antwang0/VGACorne/firmware/README.md

# Firmware

Two firmware families, chosen by the MCU module:

| Module | Firmware | Where |
|---|---|---|
| AT32F405 | [libhmk](https://github.com/peppapighs/libhmk), 8 kHz | `libhmk/keyboards/vgacorne_at32` |
| STM32F446 | libhmk, 1 kHz | `libhmk/keyboards/vgacorne_f446` |
| STM32F446 | QMK, 1 kHz | `qmk/keyboards/vgacorne` |

## libhmk

libhmk (GPL-3.0) runs with one patch; these directories hold the keyboard
definitions, laid out the way libhmk expects, and the patch:

```
libhmk/keyboards/vgacorne_at32/   AT32F405 module: USB high speed, 8 kHz
libhmk/keyboards/vgacorne_f446/   STM32F446 module: USB full speed, 1 kHz
  keyboard.json   generated by hardware/generate.py firmware; don't hand-edit the analog
                  or detachable sections
libhmk/detachable.patch           hot-plugging the VGA cable (below)
libhmk/tests/                     host test of the patched matrix.c (LIBHMK=... ./run.sh)
```

**Hot-plugging (`detachable.patch`).** Stock libhmk learns each key's rest
value only in the first 500 ms after boot, so the cable had to go in before
USB. The patch adds an optional `detachable` block to `keyboard.json`: a detect
pin and the keys behind it. We generate it with `DET` (PC4, low while the cable
is in) and the left half's 23 keys.
- **Cable out:** those keys are released at once and held. Their inputs float,
  so their readings are ignored, and can't press keys or skew the learned
  bottom-out values.
- **Cable in:** their rest values are learned afresh over 500 ms while the
  right half keeps working. Contact bounce while plugging in just restarts the
  500 ms.

The patch touches the schema, `make.py`, both drivers' `analog.c` (the detect
pin) and `matrix.c`. Without it libhmk ignores the block, and
`generate.py check` with `LIBHMK` set reports the missing patch.

Both share the same key map and mux wiring (the two MCUs use the same pin
numbers); they differ in driver, crystal (12 vs 8 MHz), USB port and PID.

## Build

```sh
git clone https://github.com/peppapighs/libhmk && cd libhmk
git apply <this repo>/firmware/libhmk/detachable.patch
cp -r <this repo>/firmware/libhmk/keyboards/vgacorne_* keyboards/
pip install platformio "pydantic~=2.11"
python setup.py -k vgacorne_at32    # or vgacorne_f446
pio run                             # -> .pio/build/<keyboard>/firmware.bin (DFU suffix added)
```

Checked against libhmk `main` (`1d2b2e2`, July 2026) in October 2026, with the
patch: AT32 33.5 KB flash / 13 KB RAM, F446 37.3 KB flash / 13 KB RAM. The left half's two mouse-column keys
are `MS_BTN1`/`MS_BTN2`; libhmk has no encoder support, so its rotary encoder
does nothing there.

## QMK (STM32F446 module)

QMK has no hall-effect support, so the keyboard brings its own analog matrix
(QMK "custom matrix lite"):

```
qmk/keyboards/vgacorne/
  he_matrix.c/.h     scan, calibration, travel curve, fixed actuation + rapid trigger, rotary encoder
  vgacorne.c         HE settings in EEPROM, HE_* keycodes, bring-up console output
  keyboard.json      generated: layout with matrix positions traced from the schematics
  he_wiring.h        generated: pins, ADC channels, remote rows, cable detect, curve table,
                     rotary encoder channel and levels, trackpad settings
  rules.mk           generated: matrix source + the trackpad's QMK driver
  config.h, halconf.h, mcuconf.h, keymaps/default (keymap.c, rules.mk)
qmk/tests/           host test of he_matrix.c against simulated sensors (./run.sh)
```

Matrix row = ADC input, column = mux channel. One scan steps all eight mux
channels and converts the six ADC inputs in a single sequence, taking about
0.23 ms. It uses `DET` (PC4) to hold the satellite half released while the VGA
cable is out and to recalibrate it when the cable comes back, as libhmk does
with `detachable.patch`.

**Trackpad.** The optional trackpad beside Y/H/N is chosen in
`hardware/vgacorne/trackpad.py`. Its QMK driver and settings are generated
into `rules.mk` and `he_wiring.h`, and it runs on I2C1 (PB6/PB7) at 400 kHz.
- **Azoteq TPS65** (default): `azoteq_iqs5xx`. Tap clicks, a two-finger tap
  right-clicks, and two fingers scroll.
- **Cirque TM040040:** `cirque_pinnacle_i2c`, with tap-to-click and circular
  scroll.
- **Buttons:** the left half's mouse column has right click beside T and
  left click beside G, with the rotary encoder below; the lower layer's left
  home row has all three buttons too.
- **Without a pad:** the driver's one failed init costs about 0.1–0.3 s at
  boot.

**Rotary encoder.** Its two contacts are summed into one of four voltages on
the left half's last spare mux channel (see
[architecture](../docs/architecture.md#mouse-column-left-half)). `he_matrix.c`
keeps that reading each scan and answers QMK's quadrature driver through
`encoder_quadrature_read_pin()`, so `ENCODER_ENABLE` and an encoder map are all
the keymap needs. Default map: scroll on base, sideways scroll on lower,
volume on raise. `ENCODER_DIRECTION_FLIP` in `config.h` reverses it.

Build:

```sh
git clone --recurse-submodules https://github.com/qmk/qmk_firmware
ln -s "$PWD/qmk/keyboards/vgacorne" qmk_firmware/keyboards/vgacorne
cd qmk_firmware && make vgacorne:default        # needs arm-none-eabi-gcc >= 10 and dfu-suffix
make vgacorne:default:flash                     # hold BOOT while plugging in first
```

Built against QMK master (September 2026) with GCC 15: 36.8 KB with the
TPS65 driver and the rotary encoder, no warnings.
GCC 7 is too old for current QMK's USB code.

| Keycode | Action |
|---|---|
| `HE_ACTU` / `HE_ACTD` | actuation point 0.1 mm deeper / shallower (default 1.5 mm) |
| `HE_RTTG` | rapid trigger on/off |
| `HE_RTSU` / `HE_RTSD` | rapid trigger less / more sensitive (default 0.3 mm) |
| `HE_CALB` | recalibrate every key (hands off for half a second) |
| `HE_DBG` | print raw/rest/bottom/distance per key (`CONSOLE_ENABLE = yes`, `qmk console`) |

The layout macro is `LAYOUT`: the Corne's 42 keys in `LAYOUT_split_3x6_3`
order, then the two mouse-column keys.

Settings persist in flash sector 1 through QMK's legacy wear-levelling
driver. ChibiOS's embedded-flash driver doesn't support the F446, and the
legacy driver only has presets for the F401/F411, which share its sector
layout; `config.h` supplies the F446 values.

**Not done yet:**
- Trackpad reads in their own thread, so they can't hold up the key scan, and
  the fix for QMK's Azoteq tap bug. Planned in
  [pointing-devices.md](pointing-devices.md), along with rotary-encoder and
  trackpad support for libhmk.
- VIA / Vial configuration. Settings are keycode-driven for now.
- Per-key actuation, DKS and SOCD. Keychron's GPL-2+ `analog_matrix` module
  has these and could be merged in.
- Fitting the travel curve (`travel_curve` in `SENSOR`) to our sensor and
  magnet. The default was fitted for GEON Raw HE switches with OH49E sensors.

## Key indices

```
 0  1  2  3  4  5 43      6  7  8  9 10 11
12 13 14 15 16 17 42     18 19 20 21 22 23
24 25 26 27 28 29 ()     30 31 32 33 34 35
          36 37 38      39 40 41
```

42 is left click, 43 right click, `()` the rotary encoder.

The default keymap is base / lower (`MO(1)`) / raise (`MO(2)`) / adjust (hold
both). Adjust has `SP_BOOT` on key 0 and profile switching `PF(0..3)`. Change
everything else in [hmkconf](https://hmkconf.com): keymaps, actuation points,
rapid trigger, tap-hold.
