antwang0/VGACorne/docs/img/module_f446-bottom.png

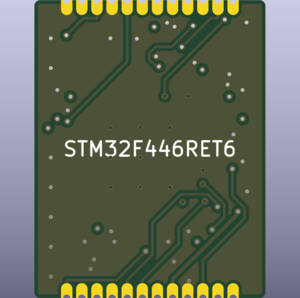
docs/img/module_f446-bottom.png
