antwang0/VGACorne/docs/img/module_f446-top.png

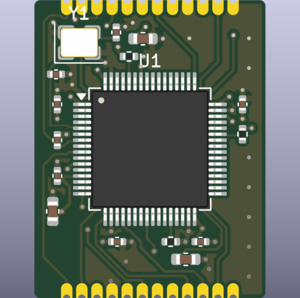
docs/img/module_f446-top.png
