antwang0/VGACorne/docs/img/satellite-bottom.png

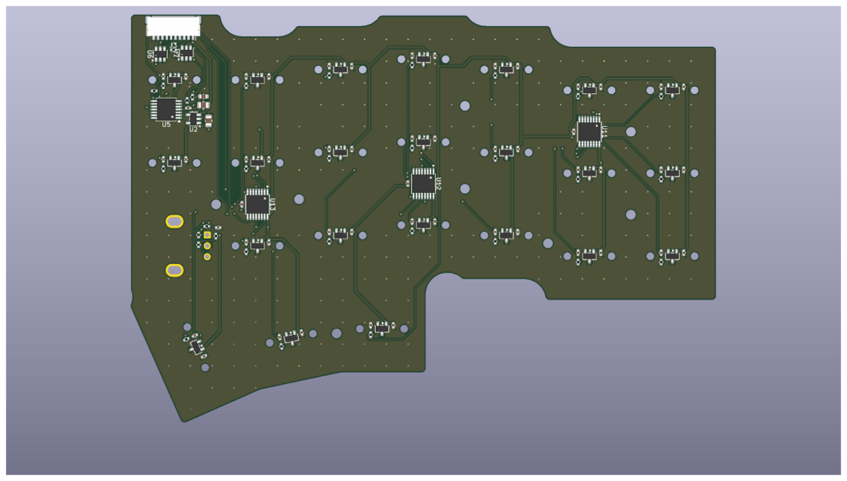
docs/img/satellite-bottom.png
