antwang0/VGACorne/hardware/bom/vgacorne-module-at32.csv

Refs | Value | Tolerance | Footprint | MPN | Qty | DNP
C1-C3,C5,C9 | 100n |  | Capacitor_SMD:C_0402_1005Metric |  | 5
C4 | 4.7u |  | Capacitor_SMD:C_0603_1608Metric |  | 1
C6 | 1u |  | Capacitor_SMD:C_0603_1608Metric |  | 1
C7,C8 | 15p |  | Capacitor_SMD:C_0402_1005Metric |  | 2
R1 | 12k | 1% | Resistor_SMD:R_0402_1005Metric |  | 1
R2 | 10k |  | Resistor_SMD:R_0402_1005Metric |  | 1
U1 | AT32F405RCT7 |  | Package_QFP:LQFP-64_10x10mm_P0.5mm | AT32F405RCT7 | 1
Y1 | 12MHz |  | Crystal:Crystal_SMD_3225-4Pin_3.2x2.5mm | X322512MOB4SI | 1
