antwang0/VGACorne/hardware/bom/vgacorne-link.csv

Refs | Value | Tolerance | Footprint | MPN | Qty | DNP
C1 | 100n |  | Capacitor_SMD:C_0402_1005Metric |  | 1
J1 | 10090929-S154XLF |  | vgacorne:DSUB-15-HD_Socket_Vertical_P2.29x1.98mm_Amphenol_10090929 | Amphenol FCI 10090929-S154XLF | 1
J2 | JST-SH pigtail |  | vgacorne:WirePads_1x10_P1.6mm |  | 1
