antwang0/VGACorne/hardware/mechanical/case-machined/case-left-tray.step

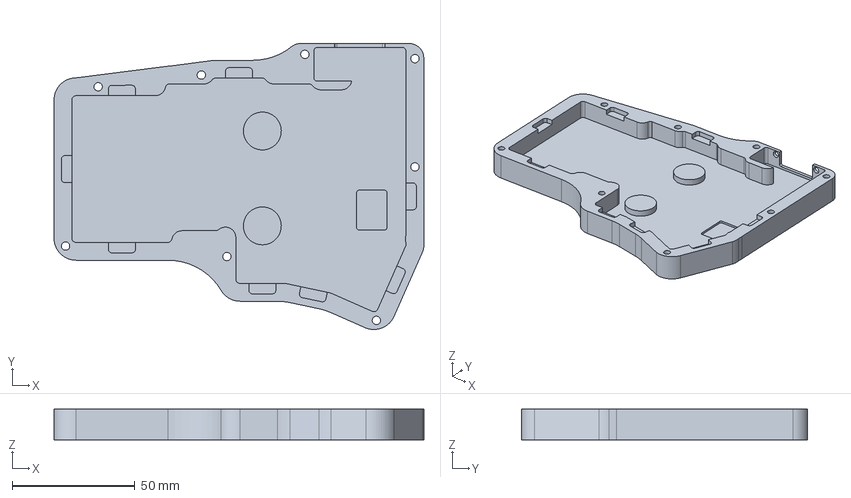
[picture p13: CAD file, 2026-11-03]
hardware/mechanical/case-machined/case-left-tray.step
150.4 x 116.3 x 12.6 mm
