antwang0/VGACorne/hardware/mechanical/case-plan-left.dxf

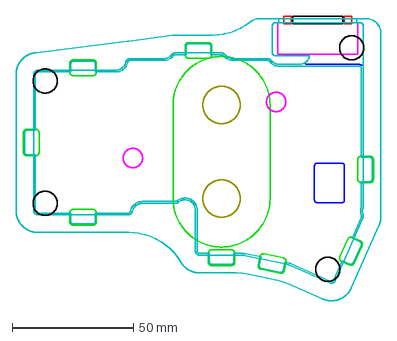
[picture p14: CAD file, 2026-11-02]
hardware/mechanical/case-plan-left.dxf
150.4 x 117.3 mm
