antwang0/VGACorne/hardware/mechanical/case-printed/case-right-frame.step

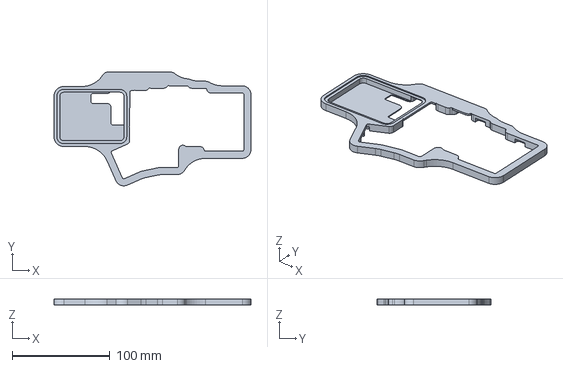
[picture p15: CAD file, 2026-11-03]
hardware/mechanical/case-printed/case-right-frame.step
201.4 x 116.3 x 6.50 mm
