antwang0/VGACorne/hardware/mechanical/case-machined/case-left-frame.step

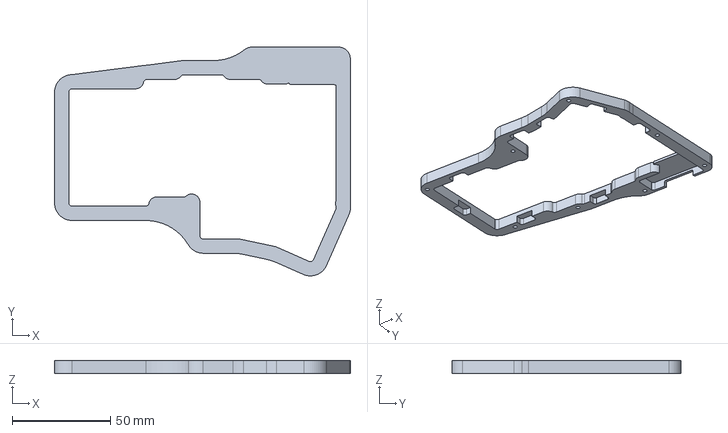
[picture p16: CAD file, 2026-11-03]
hardware/mechanical/case-machined/case-left-frame.step
150.4 x 116.3 x 6.50 mm
