antwang0/VGACorne/hardware/mechanical/case-plan-right.dxf

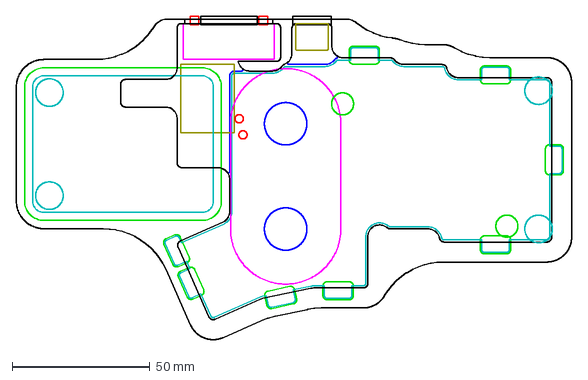
[picture p17: CAD file, 2026-11-02]
hardware/mechanical/case-plan-right.dxf
201.5 x 117.3 mm
