antwang0/VGACorne/hardware/mechanical/case-printed/case-right-tray.step

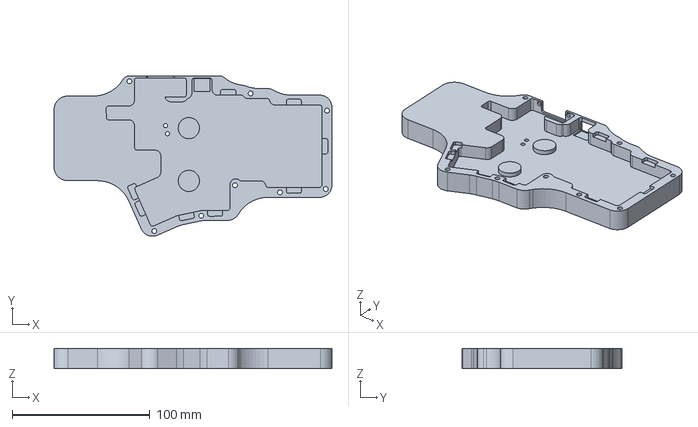
[picture p18: CAD file, 2026-11-03]
hardware/mechanical/case-printed/case-right-tray.step
201.4 x 116.3 x 14.6 mm
