antwang0/VGACorne/hardware/mechanical/case-machined/case-right-tray.step

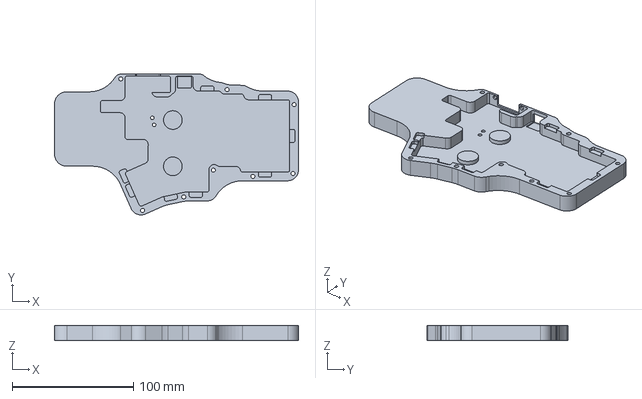
[picture p19: CAD file, 2026-11-03]
hardware/mechanical/case-machined/case-right-tray.step
201.4 x 116.3 x 12.6 mm
