antwang0/VGACorne/hardware/mechanical/case-printed/case-left-tray.step

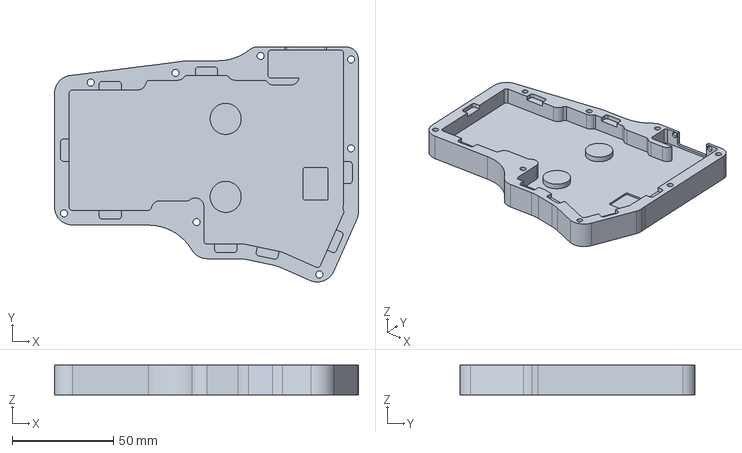
[picture p20: CAD file, 2026-11-03]
hardware/mechanical/case-printed/case-left-tray.step
150.4 x 116.3 x 14.6 mm
