antwang0/VGACorne/hardware/mechanical/foam-case-left.dxf

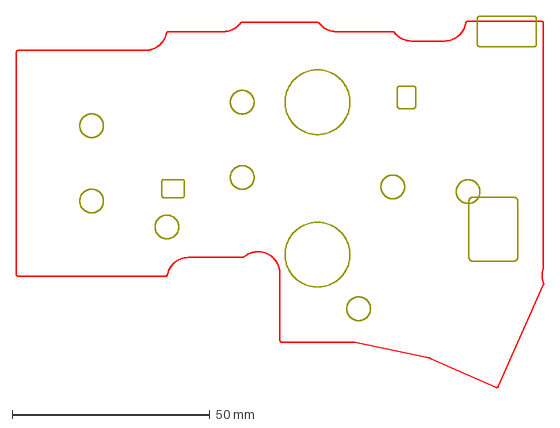
[picture p21: CAD file, 2026-11-02]
hardware/mechanical/foam-case-left.dxf
133.4 x 93.9 mm
