antwang0/VGACorne/hardware/mechanical/case-machined/case-right-frame.step

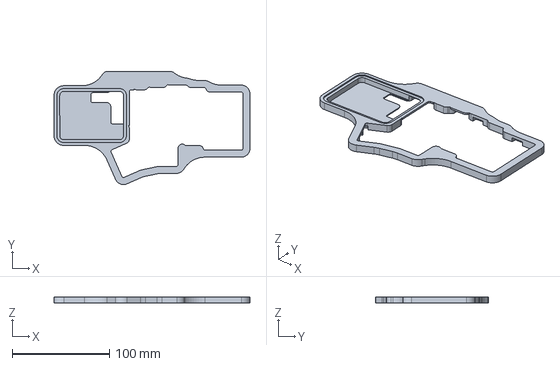
[picture p22: CAD file, 2026-11-03]
hardware/mechanical/case-machined/case-right-frame.step
201.4 x 116.3 x 6.50 mm
