antwang0/VGACorne/hardware/mechanical/foam-case-right.dxf

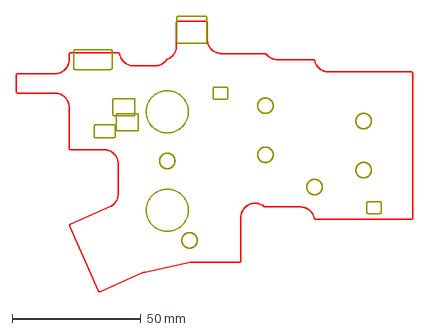
[picture p23: CAD file, 2026-11-02]
hardware/mechanical/foam-case-right.dxf
153.9 x 106.9 mm
