antwang0/VGACorne/hardware/mechanical/plate-left.dxf

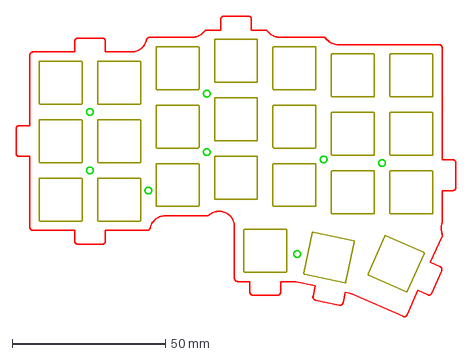
[picture p24: CAD file, 2026-09-29]
hardware/mechanical/plate-left.dxf
143.4 x 98.0 mm
