antwang0/VGACorne/hardware/mechanical/foam-plate-left.dxf

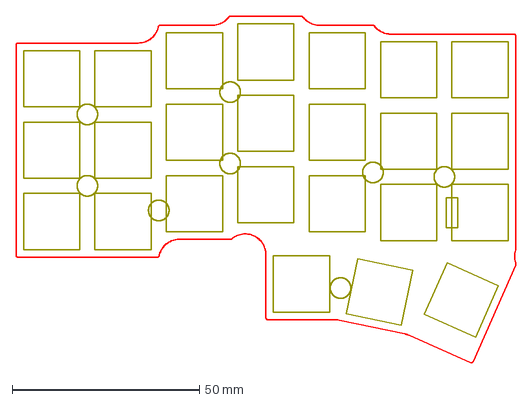
[picture p25: CAD file, 2026-09-29]
hardware/mechanical/foam-plate-left.dxf
133.4 x 92.5 mm
