antwang0/VGACorne/hardware/mechanical/foam-plate-right.dxf

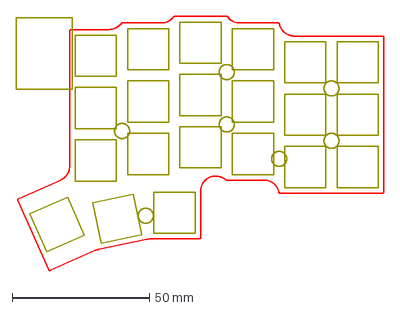
[picture p26: CAD file, 2026-09-29]
hardware/mechanical/foam-plate-right.dxf
133.8 x 92.5 mm
