antwang0/VGACorne/hardware/mechanical/pcb-outline-left.dxf

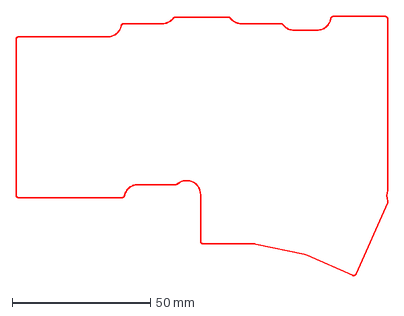
[picture p27: CAD file, 2026-09-29]
hardware/mechanical/pcb-outline-left.dxf
134.4 x 93.7 mm
