antwang0/VGACorne/hardware/mechanical/plate-right.dxf

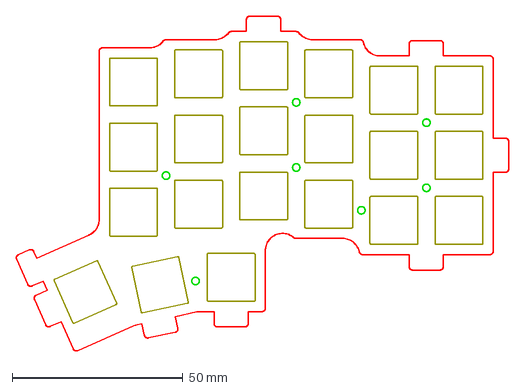
[picture p28: CAD file, 2026-09-29]
hardware/mechanical/plate-right.dxf
144.0 x 98.0 mm
