antwang0/VGACorne/hardware/mechanical/pcb-outline-right.dxf

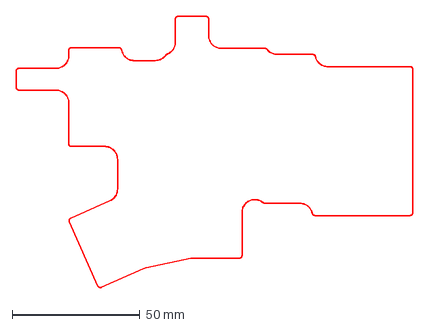
[picture p29: CAD file, 2026-09-29]
hardware/mechanical/pcb-outline-right.dxf
154.9 x 105.9 mm
