antwang0/VGACorne/(list of files, cad)

Other CAD files:
hardware/mechanical/case-printed/case-left-frame.step
hardware/mechanical/case-right-frame-inserts.step
hardware/mechanical/case-right-frame-tapped.step
hardware/mechanical/case-left-tray-tapped.step
hardware/mechanical/case-left-frame-tapped.step
hardware/mechanical/case-right-tray-tapped.step
hardware/mechanical/case-left-frame-inserts.step
hardware/mechanical/case-right-tray-inserts.step
hardware/mechanical/case-left-tray-inserts.step
hardware/mechanical/case-right-frame.step
hardware/mechanical/case-left-frame.step
hardware/mechanical/case-left-frame-tapped.dxf
hardware/mechanical/case-left-tray-tapped.dxf
hardware/mechanical/case-machined/case-left-frame.dxf
hardware/mechanical/case-machined/case-left-tray.dxf
hardware/mechanical/case-machined/case-right-frame.dxf
hardware/mechanical/case-machined/case-right-tray.dxf
hardware/mechanical/case-printed/case-left-frame.stl
hardware/mechanical/case-printed/case-left-tray.stl
hardware/mechanical/case-printed/case-right-frame.stl
hardware/mechanical/case-printed/case-right-tray.stl
hardware/mechanical/case-right-frame-tapped.dxf
hardware/mechanical/case-right-tray-tapped.dxf
