antwang0/VGACorne/docs/bring-up.md

# Ordering, assembly and bring-up

## Before ordering

- [ ] Run `hardware/generate.py check`: it must show 0 DRC errors, and
      `unconnected_items` must reach 0 on every board.
- [ ] If you swapped mux channels while routing, run `generate.py firmware`.
- [ ] Run `hardware/generate.py fab` and upload `hardware/fab/<board>/` to
      JLC: the Gerber zip, then the BOM and CPL for assembly. Check the parts'
      rotations in JLC's placement preview (hardware/README.md, *Ordering from
      JLC*).
- [ ] The VGA socket is the Amphenol FCI 10090929-S154XLF (the daughterboard
      footprint has its 1.2 mm pin holes), with Keystone 7229 jackscrews.
      Only 10 at LCSC; Digi-Key has thousands.
- [ ] Check stock for the DRV5055A3QDBZR. The second source is the
      MT9102ET; it reads the other way round, so flip `invert_adc`. See
      [sensors.md](sensors.md) and *Sensor polarity* below.
- [ ] Prefer DRV5055s on TI's newer LBC9 process: 2 mA typical instead of
      6 mA, see the [power budget](architecture.md#power-budget-usb-500-ma).
      - From ti.com, their packaging label says "Rev: C" and "CSO: RFAB".
      - Elsewhere, ask the distributor, or measure a few before buying all 44.
      - Assembly houses like JLC use whatever lot they stock; bring-up step 1
        tells you which you got. Either kind works.

## What to order

What it comes to: [cost.md](cost.md).

| Item | Qty | Notes |
|---|---|---|
| Main PCB (right half), 2-layer 1.6 mm | 1 | two-sided assembly (the trackpad FFC connector J5 is on top); J4 is bare landing pads for the module, soldered on by hand |
| MCU module, **4-layer 1.0 mm**, castellated holes | 1 | AT32F405 (libhmk, 8 kHz) or STM32F446 (QMK / libhmk); everything on top. JLC's standard 1.0 mm 4-layer stack-up (the USB pair assumes ~0.1 mm to the In1 ground plane), with the castellated-hole option |
| Satellite PCB (left half), 2-layer 1.6 mm | 1 | two-sided assembly; the rotary encoder ENC1 on top is THT (LCSC C143785, check stock: JLC may have to pre-order it, or hand-solder it) |
| VGA daughterboard | 2 | hand-solder: DE-15 (Amphenol FCI 10090929-S154XLF), 10-wire pigtail, 0402 cap |
| 4-40 female jackscrews, 0.187" hex, 0.25" stud (Keystone 7229) | 4 | two per DE-15, through the case wall into its clinch nuts |
| Plate (aluminium DXF or FR4 KiCad board) | 1 + 1 mirrored | aluminium: leave it bare or bead-blasted; the grounded standoffs tie it to GND ([grounding.md](grounding.md)) |
| Würth WE-SECF 331236362553 spring fingers (G1, G2) | 4 | aluminium case only; Farnell/RS/Mouser, no LCSC number, hand-soldered on the PCB underside |
| Case: tray + frame per half | 1 + 1 | print `mechanical/case-printed/`, or order `mechanical/case-machined/` in aluminium with its `.dxf` drawings ([mechanical.md](mechanical.md#3d-case)) |
| M3 × 12 button-head screws (ISO 7380) | 16 | tray to frame, eight per half |
| M3 × 4.0 heat-set inserts (ruthex RX-M3Sx4.0, or CNC Kitchen M3 × 3) | 16 | printed case only |
| 1/4"-20 × 6.4 heat-set inserts (CNC Kitchen or ruthex "short") | 4 | printed case only: the tripod/Arca mounts |
| Stick-on rubber feet, ~10 mm across | 8 | at the `FEET` marks in the case plan |
| Tenting or desk mount (optional) | | a mini tripod with a ball head, or an arm with an Arca clamp ([mounting.md](mounting.md)) |
| HE switches (Gateron KS-20 magnetic, GEON Raw HE, ...) | 44 | 42 + the two mouse-button keys |
| Bourns PEC12R-4220F-N0024 encoder | 1 | knob beside B (left half) |
| Knob, ~16 mm across, ~11.5 mm tall, 6 mm D-shaft bore ≥ 9.5 mm deep | 1 | up to 17 mm across; a taller knob needs a ≥ 7.5 mm recess underneath for the encoder's collar ([mechanical.md](mechanical.md#mouse-column-and-rotary-encoder-left-half)) |
| M2 hex standoffs 3.5 mm, brass | 15 | plus 30 × M2 × 3 mm screws |
| 10-pin JST-SH pigtail, ~5 cm, single-ended | 2 | plugs into J3, right in front of the daughterboard |
| VGA cable, male–male | 1 | the classic blue monitor cable is fine. It needs pins 1–3, 5–10 and 12–15 (check pin 9, see JP1/JP2 below). Both ends plug into the back of the case, so ~30 cm reaches round behind the gap |
| Azoteq TPS65-201A-S trackpad (optional) | 1 | end-of-life at Azoteq and out of stock at LCSC; Keycapsss still sells it. GR-Trackpad65 is an open clone |
| Trackpad overlay, 1 mm glass or acrylic, 71 × 55 mm, ~7 mm corners | 1 | non-metal, matte/etched top; laser-cut black acrylic works |
| 6-pin 0.5 mm FFC, ~30 mm | 1 | trackpad to J5 (Jushuo AFC07-S06FCA-00, LCSC C262553, bottom contact). Same-side or opposite-side contacts: decide with the paper mock-up (*Trackpad*, step 2) |
| PORON: 3.18 mm 4701-30 (or 3 mm LE-20) for gaskets, 1.5 mm for case foam, 3.5 mm LE-20 for plate foam | | 32 gasket strips 10 × 4.5 mm; foams cut from the DXFs ([mechanical.md](mechanical.md#foam-and-gaskets)) |

BOMs: `hardware/bom/*.csv`. Choose R11–R13 or R14–R16 to match `invert_adc`
(the DNP flags are already set from `SENSOR`).

## Daughterboards

1. Solder the DE-15 on the front, board locks included: they ground the
   shell. Clip its pin tails on the back to about 1.5 mm.
2. Try it in the case with the jackscrews before wiring. The flange should
   pull flat against the wall. Measure the board-to-flange distance: the
   design assumes about 6.1 mm.
3. On the back, solder the pigtail wires to pads 1–10. Pad 1 is marked by
   the silk bar and carries +5 V. Wire *n* must end up on pin *n* of the J3
   plug, so check the pigtail's colour order with a meter.
4. Leave JP1/JP2 bridged 1–2 (the default) unless your VGA cable lacks pin 9.
   In that case, cut both and bridge 2–3 on **both** boards.

## First power-up (main half alone)

1. **Before soldering the module:** plug in USB through a USB meter and
   measure +5V, +3V3 (U3) and +3.3VA (U2). Both 3.3 V rails are also on J4
   pads 11 and 10.
   - The current now is almost all the 21 sensors. Divide it by 21: about
     2 mA each means LBC9 parts, about 6 mA the older LBC8 ones.
   - Much more than 6 mA each means the [power budget](architecture.md#power-budget-usb-500-ma)
     needs another look.
2. Solder the module on: tack two opposite corner pads, check it sits flat and
   square on J4, then solder the rest along both edges. Plug in again: expect
   the step 1 current plus 50–90 mA for the MCU.
3. Hold **BOOT** while plugging in. The factory DFU bootloader (AT32 or STM32)
   should enumerate. SWD (Tag-Connect J2) is the fallback; it needs the bottom
   tray off.

## Flashing

```sh
git clone https://github.com/peppapighs/libhmk && cd libhmk
git apply ../VGACorne/firmware/libhmk/detachable.patch
cp -r ../VGACorne/firmware/libhmk/keyboards/vgacorne_* keyboards/
python setup.py -k vgacorne_at32 && pio run       # or -k vgacorne_f446 for the STM32 module
```

Build the keyboard that matches the fitted module: the two differ in driver,
crystal and USB speed.

**QMK (STM32F446 module):** `make vgacorne:default:flash` from a QMK checkout
with `firmware/qmk/keyboards/vgacorne` linked in (see
[firmware/README.md](../firmware/README.md#qmk-stm32f446-module)). For bring-up,
build with `CONSOLE_ENABLE = yes`, run `qmk console`, press `HE_DBG`, and watch
each key's value, rest, bottom-out and distance as you press it.

Flash over DFU (`pio run -t upload`, or WebUSB DFU as the libhmk README
suggests). After that, the `SP_BOOT` key (adjust layer: hold both
thumb-layer keys, then the top-left key) or hmkconf can re-enter the
bootloader.

## Sensor polarity and calibration

1. Connect the satellite. Each key's rest value is learned in the first 500 ms
   after USB power-up, and the left half's again for 500 ms whenever the cable
   goes in: keep your hands off the keys meanwhile.
2. Open [hmkconf](https://hmkconf.com) and watch the raw/distance view while
   pressing a key on each half.
   - If distance falls as you press, flip `invert_adc` in
     `hardware/vgacorne/circuits.py` (`SENSOR`), then regenerate: this also
     swaps which cable-unplugged pull resistors are fitted.
   - Set `initial_rest_value` / `initial_bottom_out_threshold` from what you
     observe. The rest value is HE60's; the bottom-out threshold starts at 400
     counts and grows as keys are pressed further.
   - Note the raw value at bottom-out. With the DRV5055A3, if it stays within
     about 740 counts of mid-scale (2048), the field stays under ~40 mT and a
     DRV5055A2 would double the resolution ([sensors.md](sensors.md#notes)).
3. Check every key on both halves reaches full travel. A dead column on one
   half usually means a select or analog line isn't making it through the
   cable. Beep out the VGA cable against the pinout table in
   [architecture.md](architecture.md#vga-link-pinout).
4. Hot-plug, with hmkconf (or `qmk console` and `HE_DBG`) open:
   - Unplug the cable while holding a left-half key. The key should release at
     once, and nothing on the left half should register while it's out.
   - Plug it back in. Within about half a second every left-half key should
     work again, with rest values like before.
   - If not, check that PC4 (`DET`) reads low with the cable in and high with
     it out: JP2 and cable pin 15.

## Rotary encoder (left half, QMK)

1. After soldering ENC1, trim its pins and mounting legs to about 2 mm below
   the PCB. They come through about 3 mm, close to the floor.
2. With the satellite powered, measure the `ENC` node (C5) while turning the
   shaft slowly: it should step between about 0, 1.0, 2.1 and 3.3 V. A level
   that never appears means a contact or one of R21-R24 is off.
3. In QMK the knob scrolls on the base layer, scrolls sideways on lower and
   changes the volume on raise. If it turns the wrong way, add
   `#define ENCODER_DIRECTION_FLIP` to `config.h`. One step per detent is the
   default (`ENCODER_RESOLUTION 4`); set it to 2 if an encoder gives two steps
   per detent.
4. libhmk has no encoder support: the two mouse keys work there, the knob
   doesn't.

## Trackpad (optional, QMK)

For the default Azoteq TPS65:

1. Bond the module, centred, under the overlay using its own adhesive, with a
   3 mm margin all round. Turn it so its connector is near the back edge, on
   the half nearer the keys: it then sits right over J5.
2. Mock up the FFC with a paper strip first: it drops from the module's
   connector straight into J5. Check that module pin 4 (VDDHI) lands on J5's
   +3V3 pin. The fold decides the order.
3. With USB plugged in, measure 3.3 V between the module's VDDHI and GND pads.
4. QMK looks for the pad once, at boot, about 100 ms in. If both axes come out
   reversed, add `AZOTEQ_IQS5XX_ROTATION_180` to the TPS65's `qmk_defines` in
   `trackpad.py` and regenerate (`_90`/`_270` if they come out swapped). Build
   with `CONSOLE_ENABLE = yes` and QMK's `POINTING_DEVICE_DEBUG` to see what the
   driver reads.
5. Check two known issues, see
   [firmware/pointing-devices.md](../firmware/pointing-devices.md): whether a tap
   leaves the left button held, and whether key presses lag while the pad is
   being read.

A Cirque pad (the `cirque40` entry) needs its R1 removed if it is the SPI
version (`-2024-`). Check 3.3 V on its FFC pin 12.

## Troubleshooting

| Symptom | Likely cause |
|---|---|
| Left half dead, right fine | no +5 V on VGA pin 9 (cable variant → JP1/JP2), pigtail miswired, or U8 in current limit (a short on `+5V_LINK`) |
| Left half keys stuck pressed after plugging the cable in late | libhmk built without `detachable.patch`, or `DET` not reaching PC4 (JP2, cable pin 15). Recalibrate in hmkconf or re-plug USB meanwhile |
| One column on the left dead | a `LINK_A/B/C` coax line: cable or daughterboard solder joint |
| Keys fine, trackpad dead | FFC reversed or folded the wrong way, the FFC seated after power-up (QMK only looks at boot), or, for a Cirque, an SPI pad with R1 still fitted |
| Knob scrolls in bursts or backwards on some detents | a missing level on `ENC` (see *Rotary encoder*) |
| Keys trigger randomly with the cable unplugged | `DET` not going high (PC4 shorted, or libhmk without `detachable.patch`), and the pull resistor set doesn't match `invert_adc` |
| Rest value drifts when pressing on the plate | a standoff screw is loose, so the plate flexes against the PCB |
