antwang0/VGACorne/hardware/kicad/main/vgacorne-main.kicad_pcb

## KiCad design hardware/kicad/main/vgacorne-main.kicad_pcb (2026-11-02)

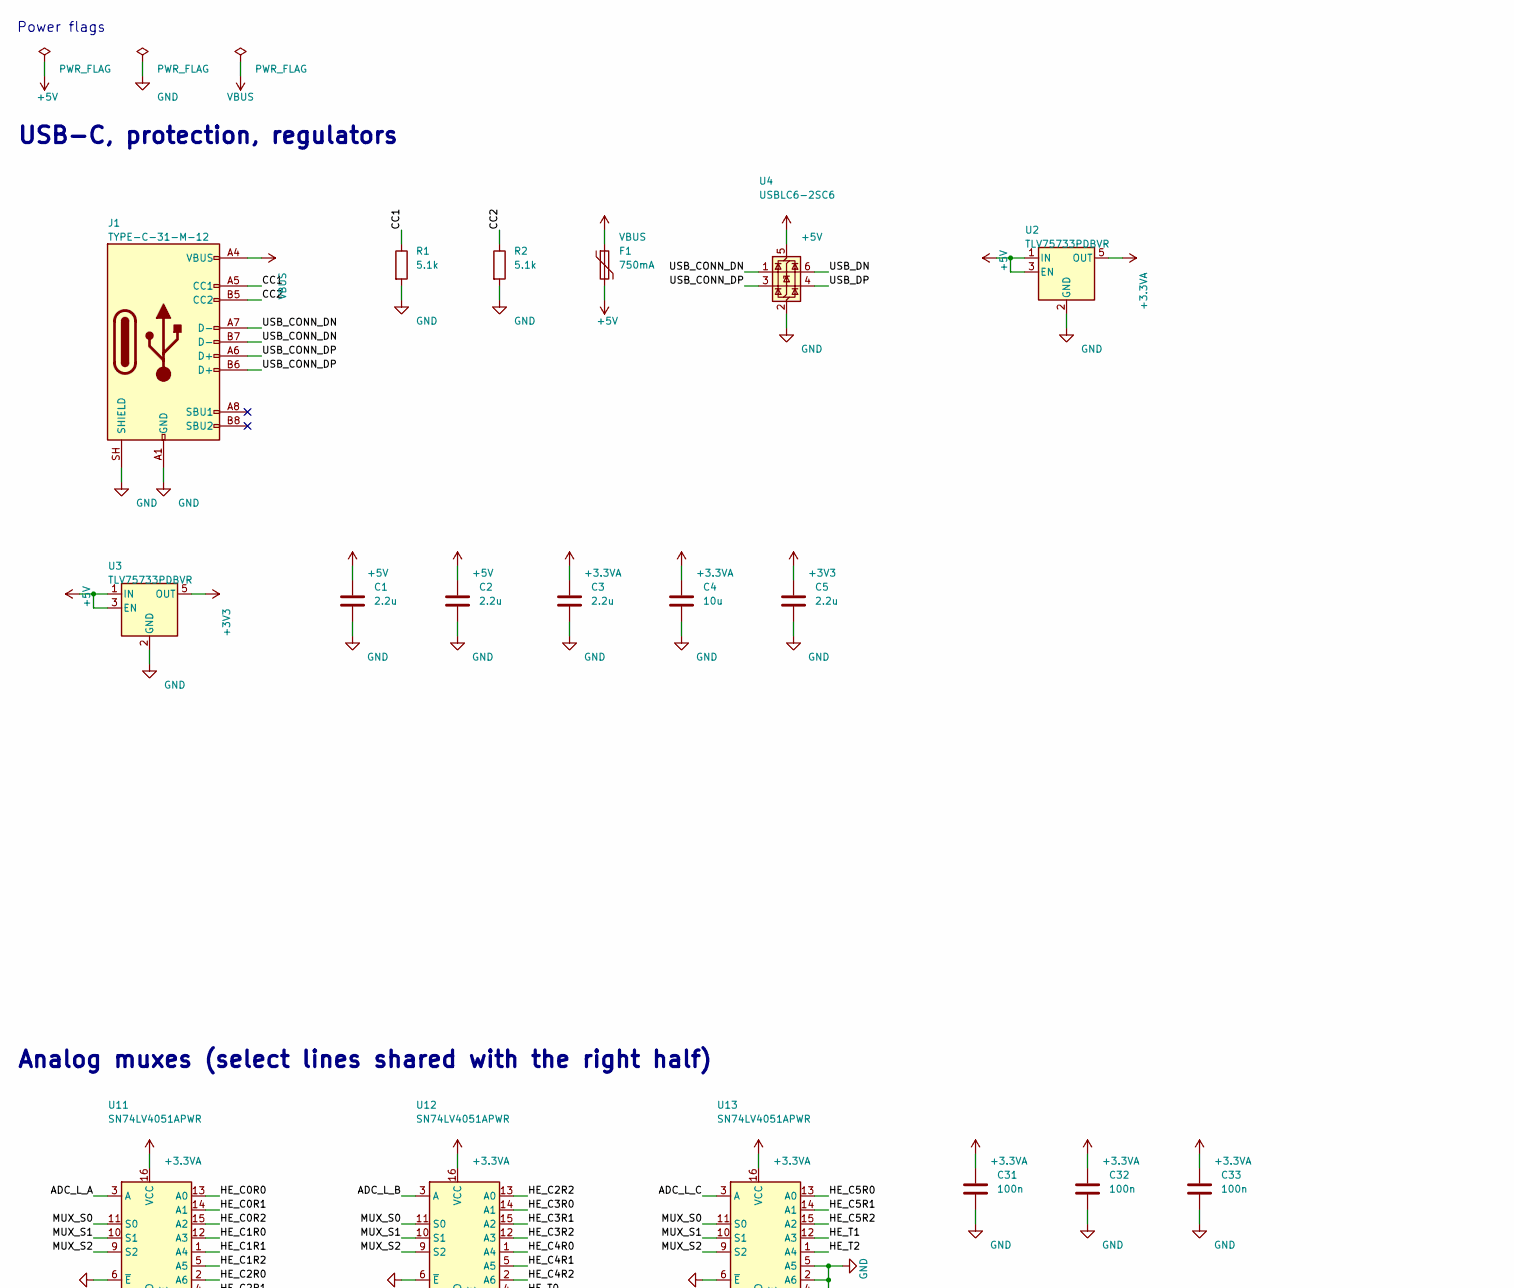
[picture p30: schematic vgacorne-main.kicad_sch, VGACorne - main (right) half, part in row 1, column 1]

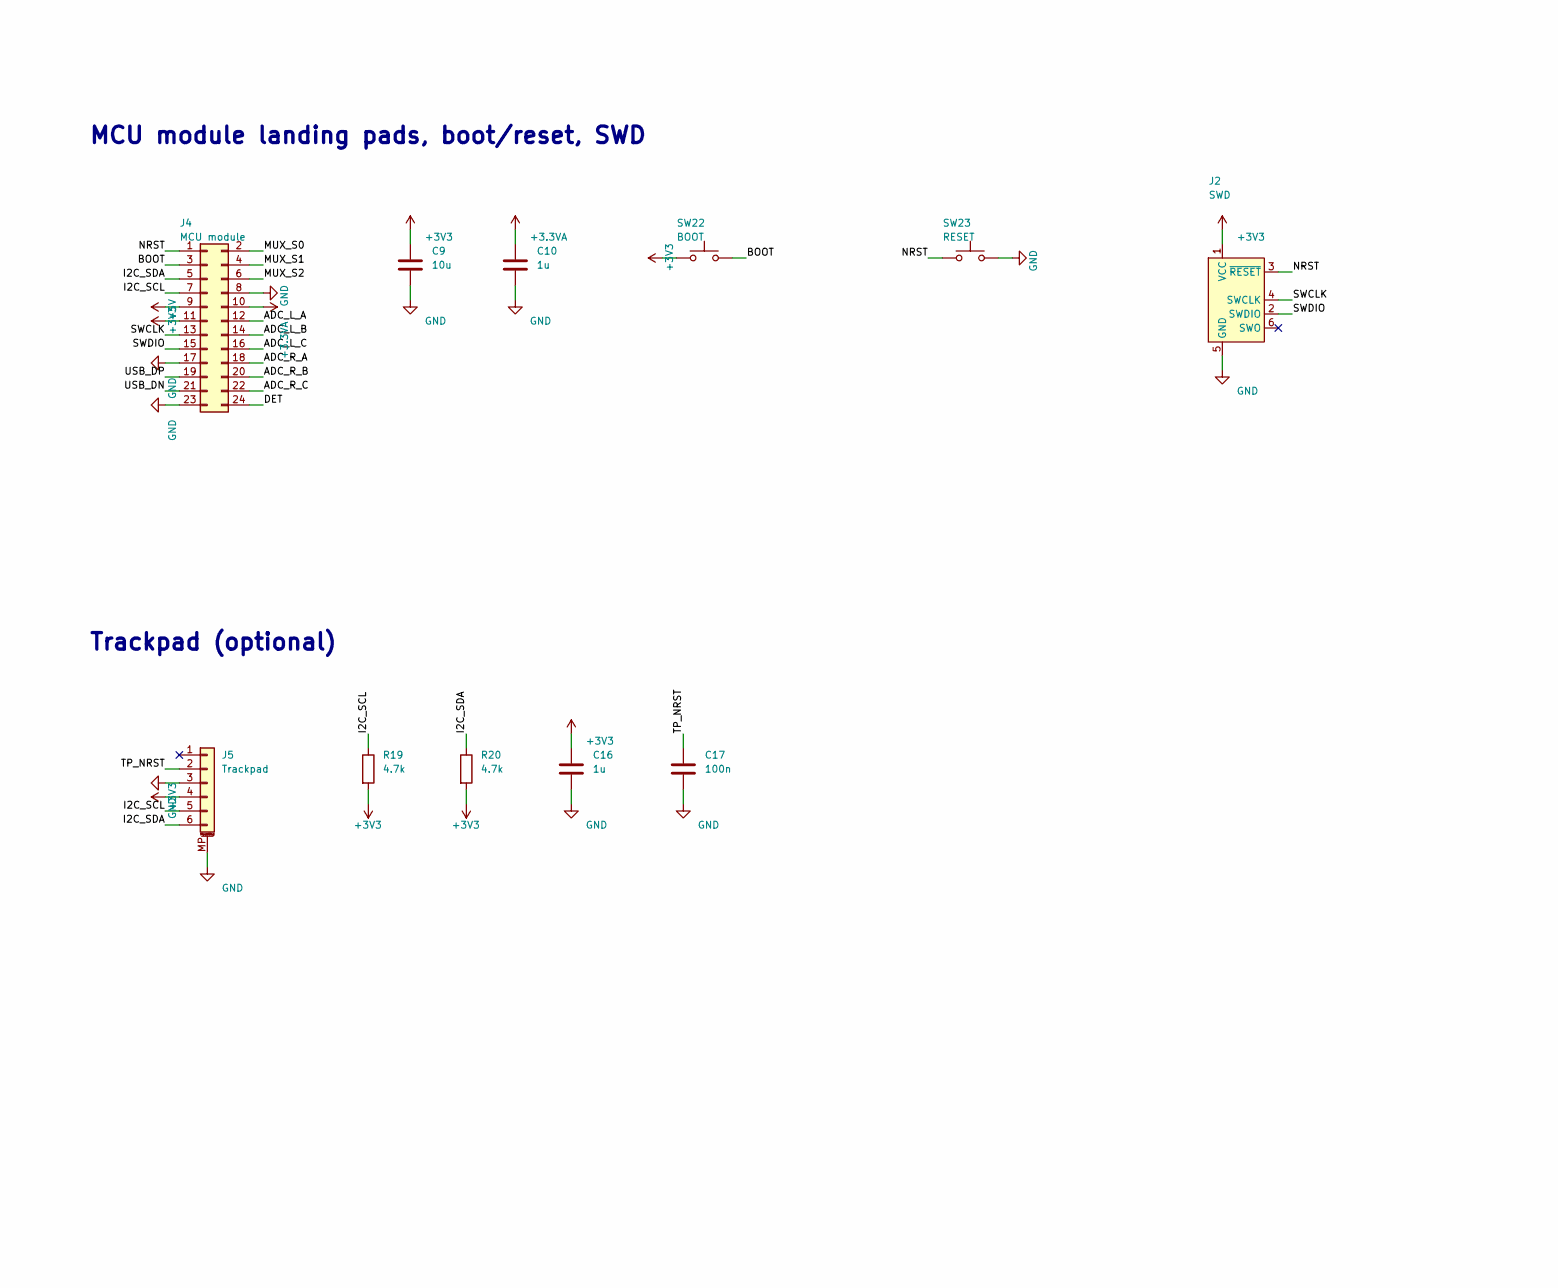
[picture p31: schematic vgacorne-main.kicad_sch, VGACorne - main (right) half, part in row 1, column 2]

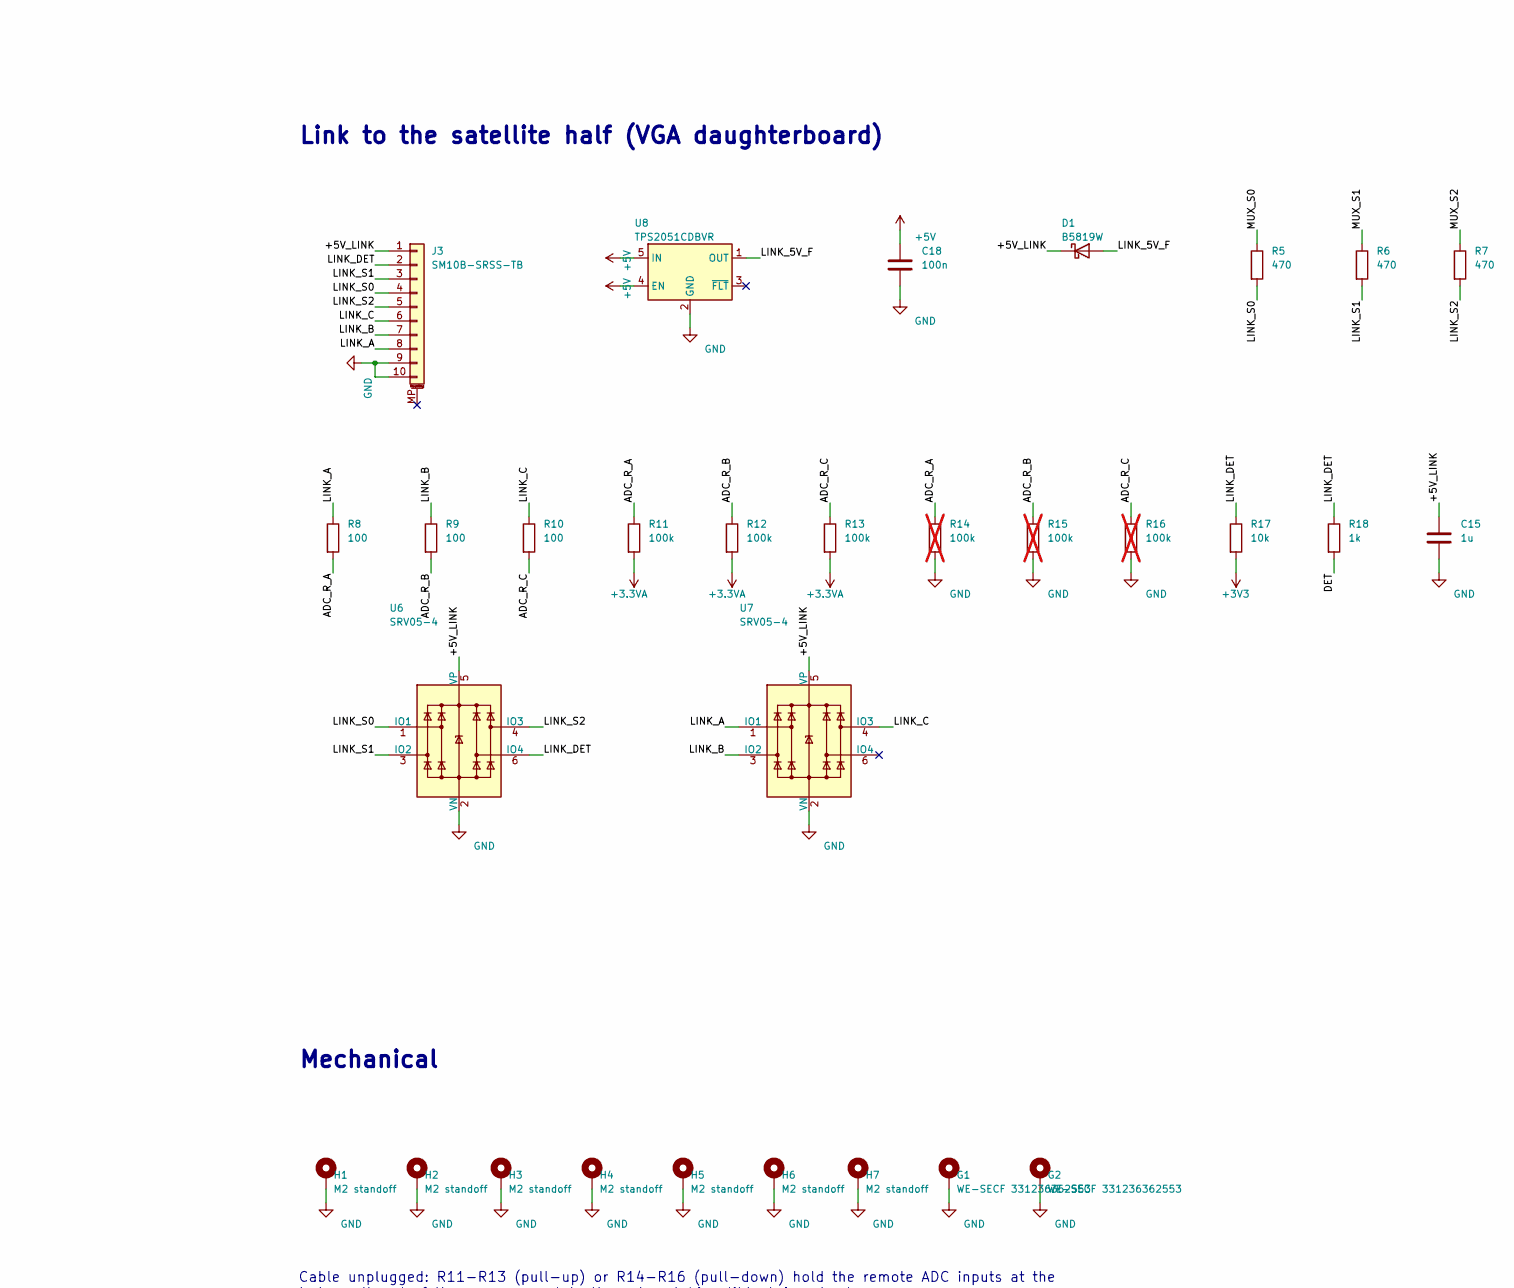
[picture p32: schematic vgacorne-main.kicad_sch, VGACorne - main (right) half, part in row 1, column 3]

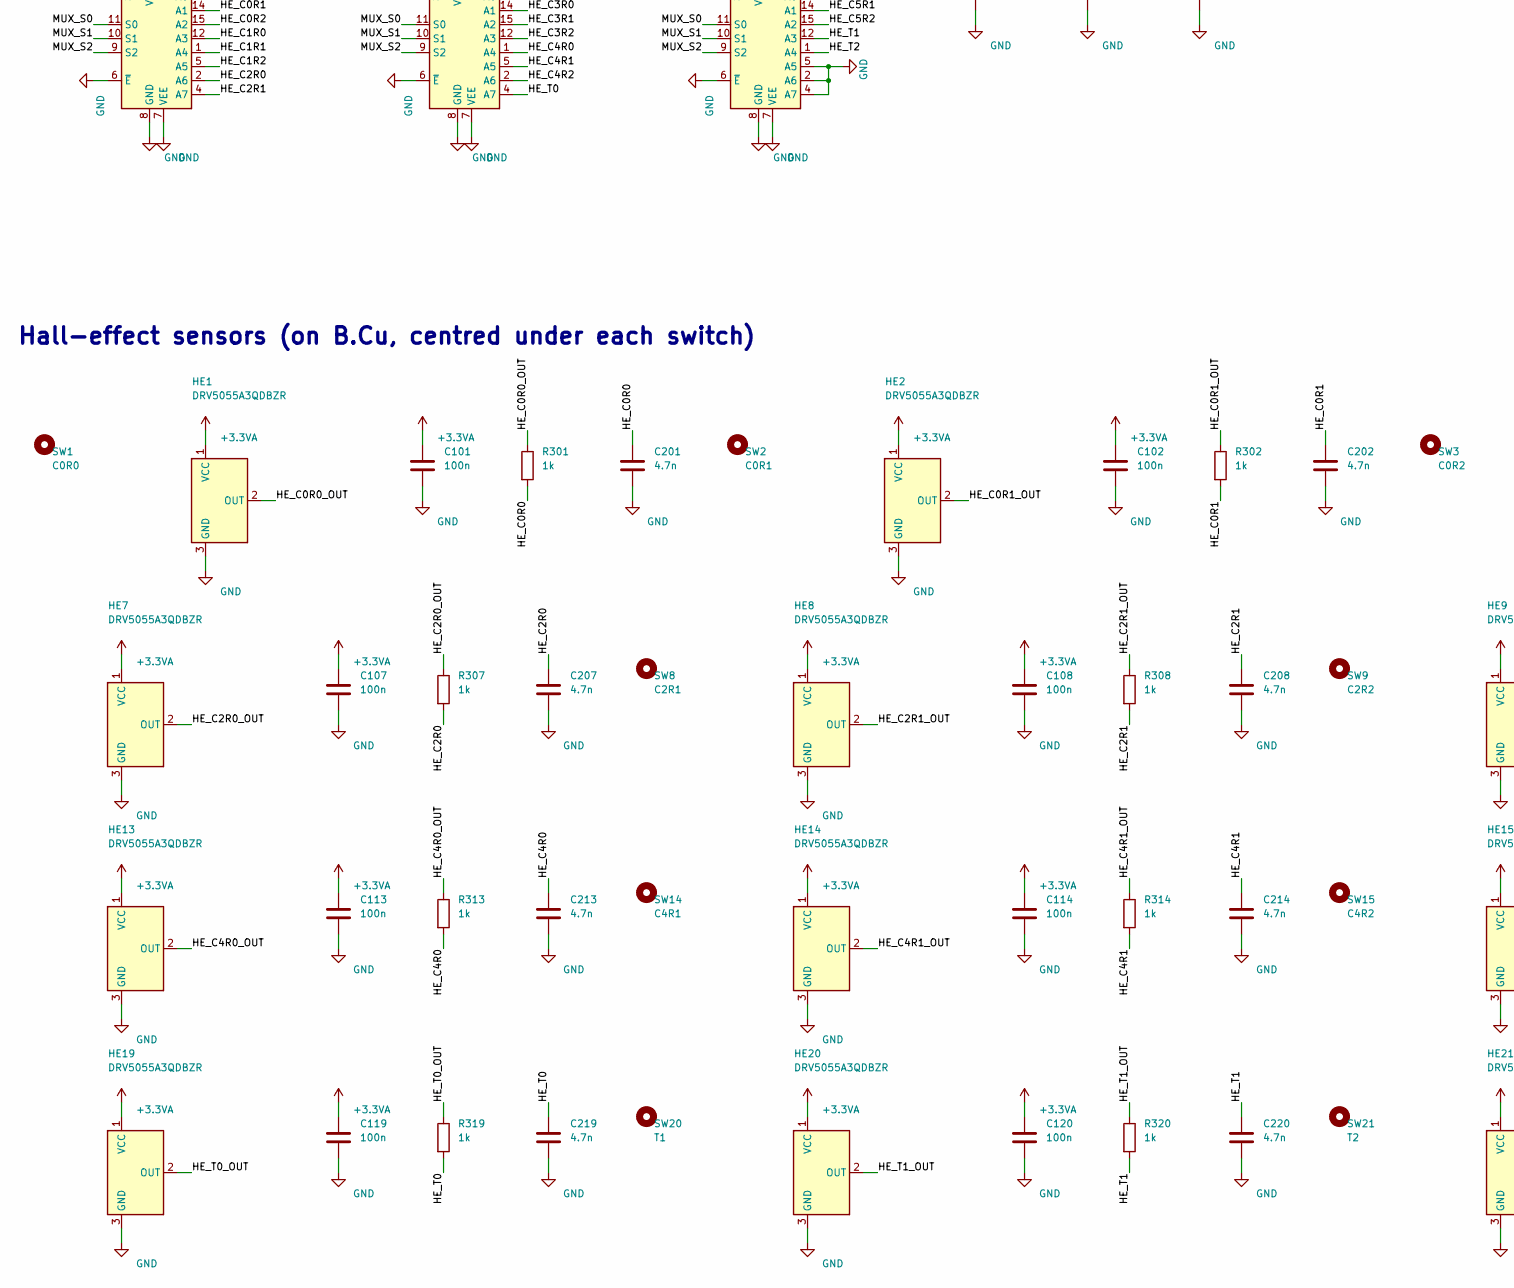
[picture p33: schematic vgacorne-main.kicad_sch, VGACorne - main (right) half, part in row 2, column 1]

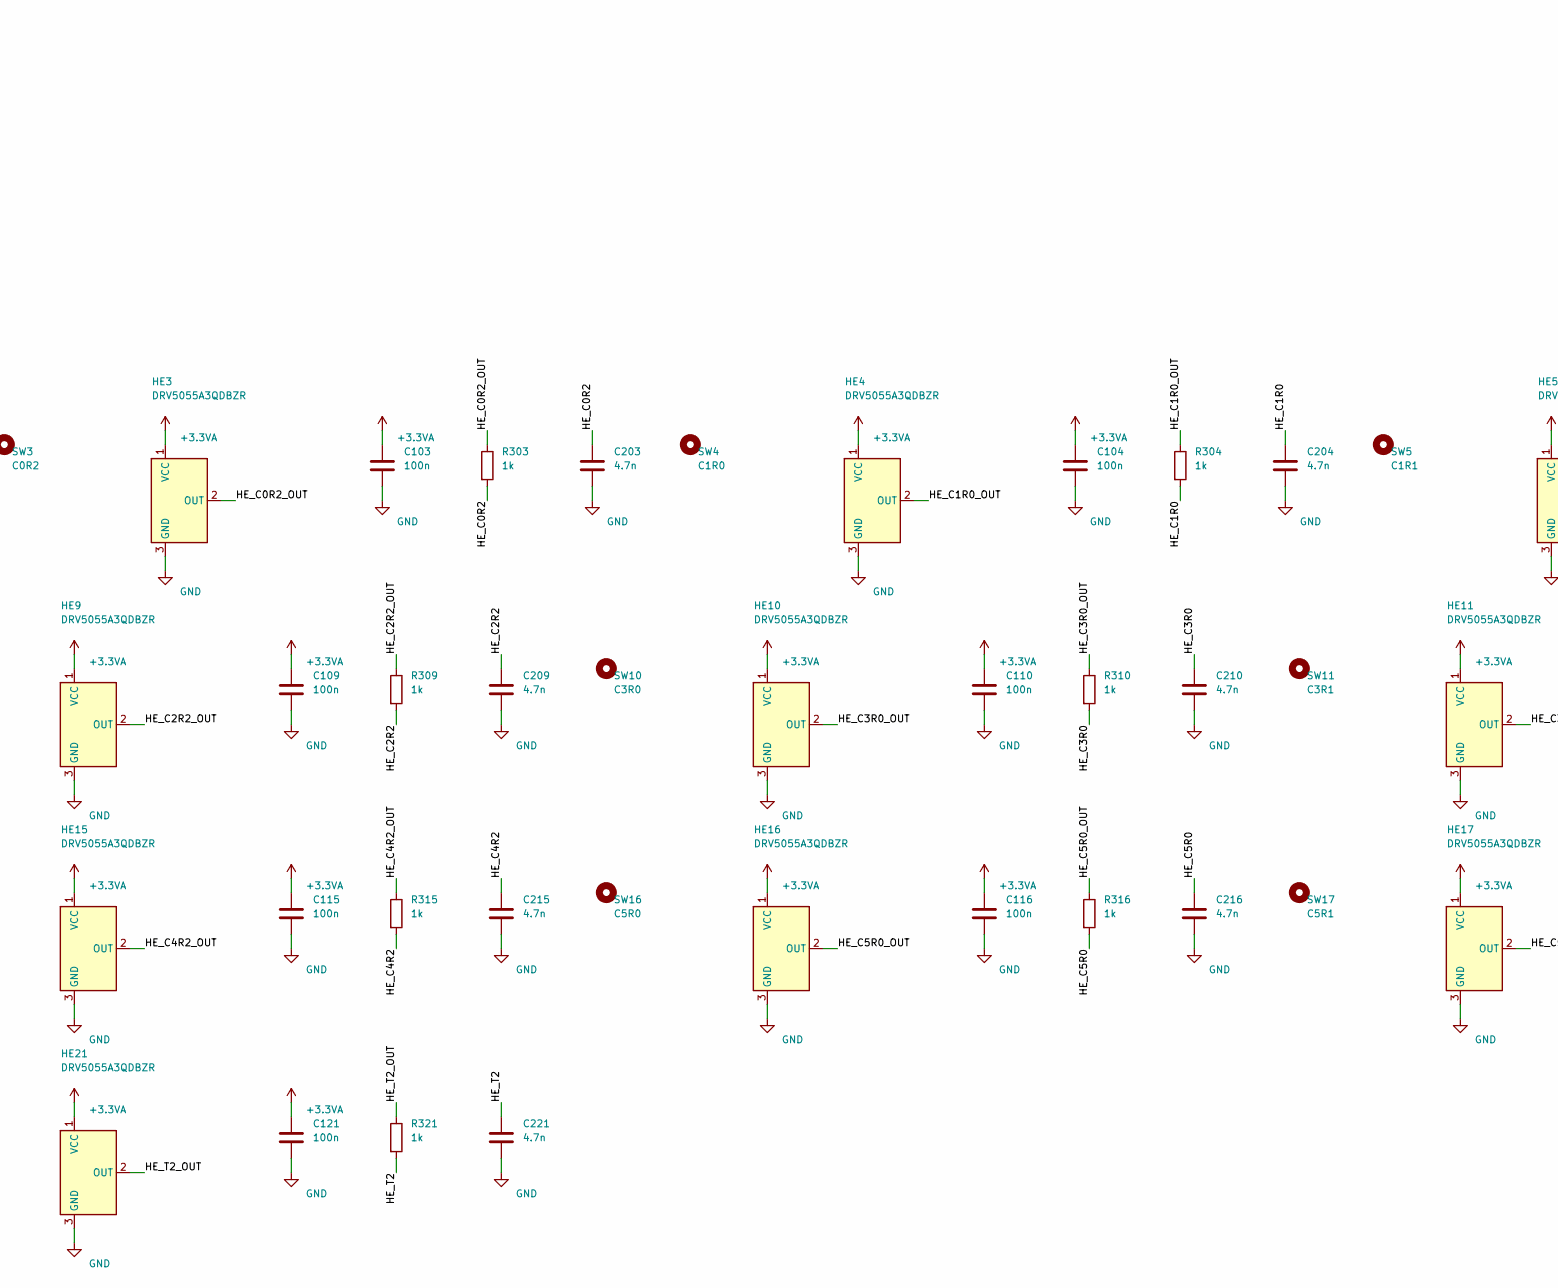
[picture p34: schematic vgacorne-main.kicad_sch, VGACorne - main (right) half, part in row 2, column 2]

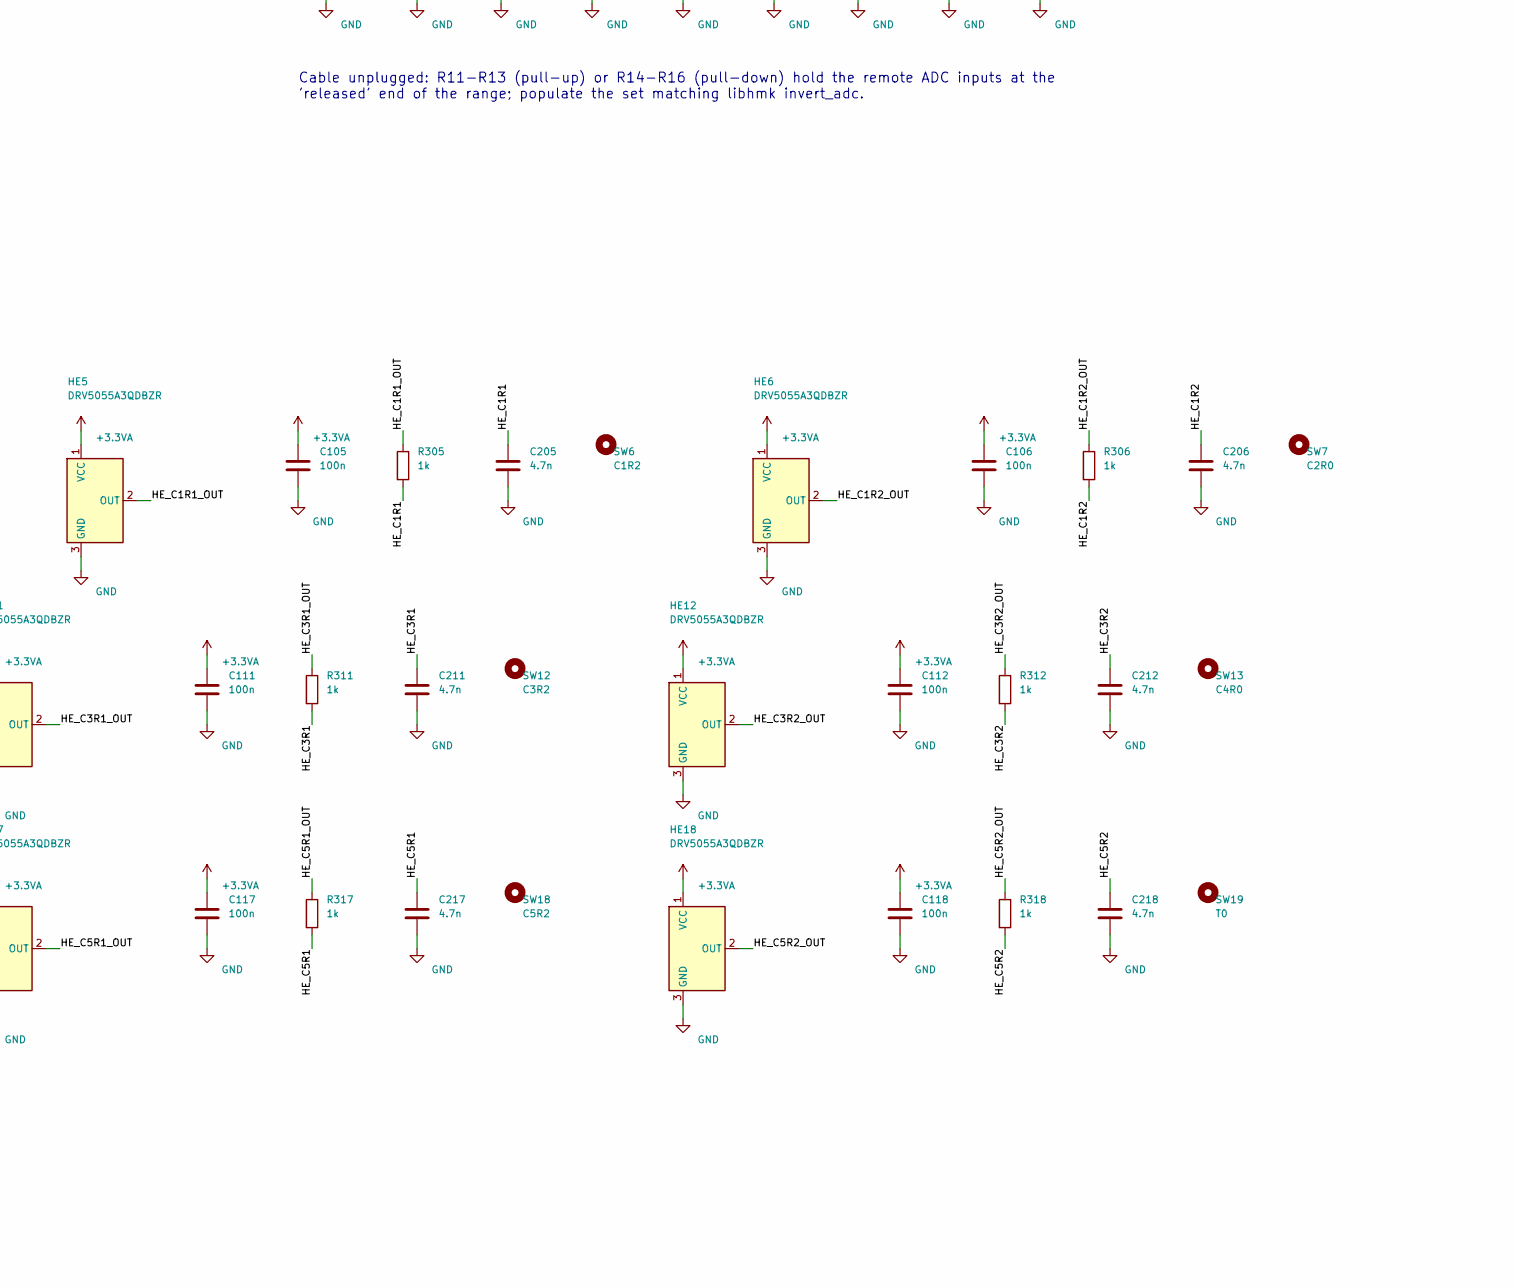
[picture p35: schematic vgacorne-main.kicad_sch, VGACorne - main (right) half, part in row 2, column 3]

Parts:
C1, C2, C3, C5: 2.2u; C_0603_1608Metric
C4, C9: 10u; C_0805_2012Metric
C10, C15, C16: 1u; C_0603_1608Metric
C17, C18, C31, C32, C33, C101, C102, C103, C104, C105, C106, C107, C108, C109, C110, C111, C112, C113, C114, C115, C116, C117, C118, C119, C120, C121: 100n; C_0402_1005Metric
C201, C202, C203, C204, C205, C206, C207, C208, C209, C210, C211, C212, C213, C214, C215, C216, C217, C218, C219, C220, C221: 4.7n; C_0402_1005Metric
D1: B5819W; D_SOD-123; MPN B5819W
F1: 750mA; Fuse_0805_2012Metric; MPN SMD0805-075
G1, G2: WE-SECF 331236362553; EMI_Finger_WE-SECF_3.6x2.5mm; MPN 331236362553
H1, H2, H3, H4, H5, H6, H7: M2 standoff; Standoff_M2
HE1, HE2, HE3, HE4, HE5, HE6, HE7, HE8, HE9, HE10, HE11, HE12, HE13, HE14, HE15, HE16, HE17, HE18, HE19, HE20, HE21: DRV5055A3QDBZR; SOT-23; MPN DRV5055A3QDBZR
J1: TYPE-C-31-M-12; USB_C_Receptacle_HRO_TYPE-C-31-M-12; MPN HRO TYPE-C-31-M-12
J2: SWD; Tag-Connect_TC2030-IDC-NL_2x03_P1.27mm_Vertical
J3: SM10B-SRSS-TB; JST_SH_SM10B-SRSS-TB_1x10-1MP_P1.00mm_Horizontal; MPN SM10B-SRSS-TB
J4: MCU module; Module_Castellated_Landing_2x12_P1.27mm_19.4x25mm
J5: Trackpad; Jushuo_AFC07-S06FCA-00_1x6-1MP_P0.50_Horizontal; MPN AFC07-S06FCA-00
R1, R2: 5.1k; R_0402_1005Metric
R5, R6, R7: 470; R_0402_1005Metric
R8, R9, R10: 100; R_0402_1005Metric
R11, R12, R13: 100k; R_0402_1005Metric
R14, R15, R16: 100k; R_0402_1005Metric; not fitted
R17: 10k; R_0402_1005Metric
R18, R301, R302, R303, R304, R305, R306, R307, R308, R309, R310, R311, R312, R313, R314, R315, R316, R317, R318, R319, R320, R321: 1k; R_0402_1005Metric
R19, R20: 4.7k; R_0402_1005Metric
SW1: C0R0; SW_HE_MX_1u
SW2: C0R1; SW_HE_MX_1u
SW3: C0R2; SW_HE_MX_1u
SW4: C1R0; SW_HE_MX_1u
SW5: C1R1; SW_HE_MX_1u
SW6: C1R2; SW_HE_MX_1u
SW7: C2R0; SW_HE_MX_1u
SW8: C2R1; SW_HE_MX_1u
SW9: C2R2; SW_HE_MX_1u
SW10: C3R0; SW_HE_MX_1u
SW11: C3R1; SW_HE_MX_1u
SW12: C3R2; SW_HE_MX_1u
SW13: C4R0; SW_HE_MX_1u
SW14: C4R1; SW_HE_MX_1u
SW15: C4R2; SW_HE_MX_1u
SW16: C5R0; SW_HE_MX_1u
SW17: C5R1; SW_HE_MX_1u
SW18: C5R2; SW_HE_MX_1u
SW19: T0; SW_HE_MX_1u
SW20: T1; SW_HE_MX_1u
SW21: T2; SW_HE_MX_1.5u
SW22: BOOT; SW_Push_1P1T_XKB_TS-1187A; MPN TS-1187A-B-A-B
SW23: RESET; SW_Push_1P1T_XKB_TS-1187A; MPN TS-1187A-B-A-B
U2, U3: TLV75733PDBVR; SOT-23-5; MPN TLV75733PDBVR
U4: USBLC6-2SC6; SOT-23-6; MPN USBLC6-2SC6
U6, U7: SRV05-4; SOT-23-6; MPN SRV05-4
U8: TPS2051CDBVR; SOT-23-5; MPN TPS2051CDBVR
U11, U12, U13: SN74LV4051APWR; TSSOP-16_4.4x5mm_P0.65mm; MPN SN74LV4051APWR

Connections:
+3.3VA: C3.1, C4.1, C10.1, C31.1, C32.1, C33.1, C101.1, C102.1, C103.1, C104.1, C105.1, C106.1, C107.1, C108.1, C109.1, C110.1, C111.1, C112.1, C113.1, C114.1, C115.1, C116.1, C117.1, C118.1, C119.1, C120.1, C121.1, HE1.1 (VCC), HE2.1 (VCC), HE3.1 (VCC), HE4.1 (VCC), HE5.1 (VCC), HE6.1 (VCC), HE7.1 (VCC), HE8.1 (VCC), HE9.1 (VCC), HE10.1 (VCC), HE11.1 (VCC), HE12.1 (VCC), HE13.1 (VCC), HE14.1 (VCC), HE15.1 (VCC), HE16.1 (VCC), HE17.1 (VCC), HE18.1 (VCC), HE19.1 (VCC), HE20.1 (VCC), HE21.1 (VCC), J4.10, R11.2, R12.2, R13.2, U2.5 (OUT), U11.16 (VCC), U12.16 (VCC), U13.16 (VCC)
+3V3: C5.1, C9.1, C16.1, J2.1 (VCC), J4.11, J5.4, R17.2, R19.2, R20.2, SW22.1, U3.5 (OUT)
+5V: C1.1, C2.1, C18.1, F1.2, J4.9, U2.1 (IN), U2.3 (EN), U3.1 (IN), U3.3 (EN), U4.5 (VBUS), U8.4 (EN), U8.5 (IN)
/+5V_LINK: C15.1, D1.1 (K), J3.1, U6.5 (VP), U7.5 (VP)
/ADC_L_A: J4.12, U11.3 (A)
/ADC_L_B: J4.14, U12.3 (A)
/ADC_L_C: J4.16, U13.3 (A)
/ADC_R_A: J4.18, R8.2, R11.1, R14.1
/ADC_R_B: J4.20, R9.2, R12.1, R15.1
/ADC_R_C: J4.22, R10.2, R13.1, R16.1
/BOOT: J4.3, SW22.2
/CC1: J1.A5 (CC1), R1.1
/CC2: J1.B5 (CC2), R2.1
/DET: J4.24, R18.2
/HE_C0R0: C201.1, R301.2, U11.13 (A0)
/HE_C0R0_OUT: HE1.2 (OUT), R301.1
/HE_C0R1: C202.1, R302.2, U11.14 (A1)
/HE_C0R1_OUT: HE2.2 (OUT), R302.1
/HE_C0R2: C203.1, R303.2, U11.15 (A2)
/HE_C0R2_OUT: HE3.2 (OUT), R303.1
/HE_C1R0: C204.1, R304.2, U11.12 (A3)
/HE_C1R0_OUT: HE4.2 (OUT), R304.1
/HE_C1R1: C205.1, R305.2, U11.1 (A4)
/HE_C1R1_OUT: HE5.2 (OUT), R305.1
/HE_C1R2: C206.1, R306.2, U11.5 (A5)
/HE_C1R2_OUT: HE6.2 (OUT), R306.1
/HE_C2R0: C207.1, R307.2, U11.2 (A6)
/HE_C2R0_OUT: HE7.2 (OUT), R307.1
/HE_C2R1: C208.1, R308.2, U11.4 (A7)
/HE_C2R1_OUT: HE8.2 (OUT), R308.1
/HE_C2R2: C209.1, R309.2, U12.13 (A0)
/HE_C2R2_OUT: HE9.2 (OUT), R309.1
/HE_C3R0: C210.1, R310.2, U12.14 (A1)
/HE_C3R0_OUT: HE10.2 (OUT), R310.1
/HE_C3R1: C211.1, R311.2, U12.15 (A2)
/HE_C3R1_OUT: HE11.2 (OUT), R311.1
/HE_C3R2: C212.1, R312.2, U12.12 (A3)
/HE_C3R2_OUT: HE12.2 (OUT), R312.1
/HE_C4R0: C213.1, R313.2, U12.1 (A4)
/HE_C4R0_OUT: HE13.2 (OUT), R313.1
/HE_C4R1: C214.1, R314.2, U12.5 (A5)
/HE_C4R1_OUT: HE14.2 (OUT), R314.1
/HE_C4R2: C215.1, R315.2, U12.2 (A6)
/HE_C4R2_OUT: HE15.2 (OUT), R315.1
/HE_C5R0: C216.1, R316.2, U13.13 (A0)
/HE_C5R0_OUT: HE16.2 (OUT), R316.1
/HE_C5R1: C217.1, R317.2, U13.14 (A1)
/HE_C5R1_OUT: HE17.2 (OUT), R317.1
/HE_C5R2: C218.1, R318.2, U13.15 (A2)
/HE_C5R2_OUT: HE18.2 (OUT), R318.1
/HE_T0: C219.1, R319.2, U12.4 (A7)
/HE_T0_OUT: HE19.2 (OUT), R319.1
/HE_T1: C220.1, R320.2, U13.12 (A3)
/HE_T1_OUT: HE20.2 (OUT), R320.1
/HE_T2: C221.1, R321.2, U13.1 (A4)
/HE_T2_OUT: HE21.2 (OUT), R321.1
/I2C_SCL: J4.7, J5.5, R19.1
/I2C_SDA: J4.5, J5.6, R20.1
/LINK_5V_F: D1.2 (A), U8.1 (OUT)
/LINK_A: J3.8, R8.1, U7.1 (IO1)
/LINK_B: J3.7, R9.1, U7.3 (IO2)
/LINK_C: J3.6, R10.1, U7.4 (IO3)
/LINK_DET: J3.2, R17.1, R18.1, U6.6 (IO4)
/LINK_S0: J3.4, R5.2, U6.1 (IO1)
/LINK_S1: J3.3, R6.2, U6.3 (IO2)
/LINK_S2: J3.5, R7.2, U6.4 (IO3)
/MUX_S0: J4.2, R5.1, U11.11 (S0), U12.11 (S0), U13.11 (S0)
/MUX_S1: J4.4, R6.1, U11.10 (S1), U12.10 (S1), U13.10 (S1)
/MUX_S2: J4.6, R7.1, U11.9 (S2), U12.9 (S2), U13.9 (S2)
/NRST: J2.3 (~RESET), J4.1, SW23.1
/SWCLK: J2.4 (SWCLK), J4.13
/SWDIO: J2.2 (SWDIO), J4.15
/TP_NRST: C17.1, J5.2
/USB_CONN_DN: J1.A7 (D-), J1.B7 (D-), U4.1 (I/O1)
/USB_CONN_DP: J1.A6 (D+), J1.B6 (D+), U4.3 (I/O2)
/USB_DN: J4.21, U4.6 (I/O1)
/USB_DP: J4.19, U4.4 (I/O2)
GND: C1.2, C2.2, C3.2, C4.2, C5.2, C9.2, C10.2, C15.2, C16.2, C17.2, C18.2, C31.2, C32.2, C33.2, C101.2, C102.2, C103.2, C104.2, C105.2, C106.2, C107.2, C108.2, C109.2, C110.2, C111.2, C112.2, C113.2, C114.2, C115.2, C116.2, C117.2, C118.2, C119.2, C120.2, C121.2, C201.2, C202.2, C203.2, C204.2, C205.2, C206.2, C207.2, C208.2, C209.2, C210.2, C211.2, C212.2, C213.2, C214.2, C215.2, C216.2, C217.2, C218.2, C219.2, C220.2, C221.2, G1.1, G2.1, H1.1, H2.1, H3.1, H4.1, H5.1, H6.1, H7.1, HE1.3 (GND), HE2.3 (GND), HE3.3 (GND), HE4.3 (GND), HE5.3 (GND), HE6.3 (GND), HE7.3 (GND), HE8.3 (GND), HE9.3 (GND), HE10.3 (GND), HE11.3 (GND), HE12.3 (GND), HE13.3 (GND), HE14.3 (GND), HE15.3 (GND), HE16.3 (GND), HE17.3 (GND), HE18.3 (GND), HE19.3 (GND), HE20.3 (GND), HE21.3 (GND), J1.A1 (GND), J1.A12 (GND), J1.B1 (GND), J1.B12 (GND), J1.SH (SHIELD), J2.5 (GND), J3.9, J3.10, J4.8, J4.17, J4.23, J5.3, J5.MP (MountPin), R1.2, R2.2, R14.2, R15.2, R16.2, SW23.2, U2.2 (GND), U3.2 (GND), U4.2 (GND), U6.2 (VN), U7.2 (VN), U8.2 (GND), U11.6 (~E), U11.7 (VEE), U11.8 (GND), U12.6 (~E), U12.7 (VEE), U12.8 (GND), U13.2 (A6), U13.4 (A7), U13.5 (A5), U13.6 (~E), U13.7 (VEE), U13.8 (GND)
VBUS: F1.1, J1.A4 (VBUS), J1.A9 (VBUS), J1.B4 (VBUS), J1.B9 (VBUS)

Notes on the sheet:
USB-C, protection, regulators
MCU module landing pads, boot/reset, SWD
Link to the satellite half (VGA daughterboard)
Trackpad (optional)
Analog muxes (select lines shared with the right half)
Mechanical
Hall-effect sensors (on B.Cu, centred under each switch)
Cable unplugged: R11-R13 (pull-up) or R14-R16 (pull-down) hold the remote ADC inputs at the 'released' end of the range; populate the set matching libhmk invert_adc.
Power flags

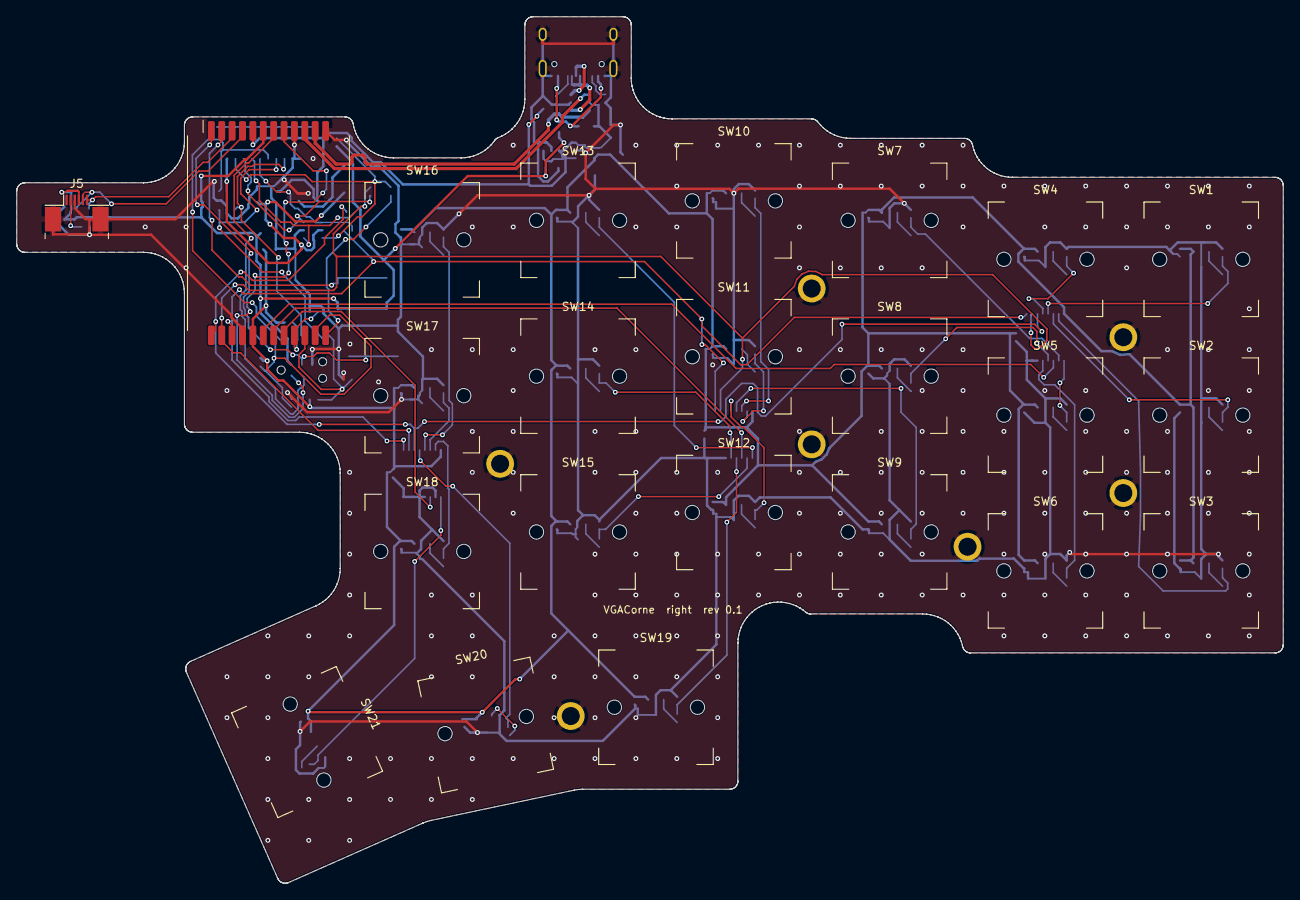
[picture p36: board vgacorne-main.kicad_pcb from above]

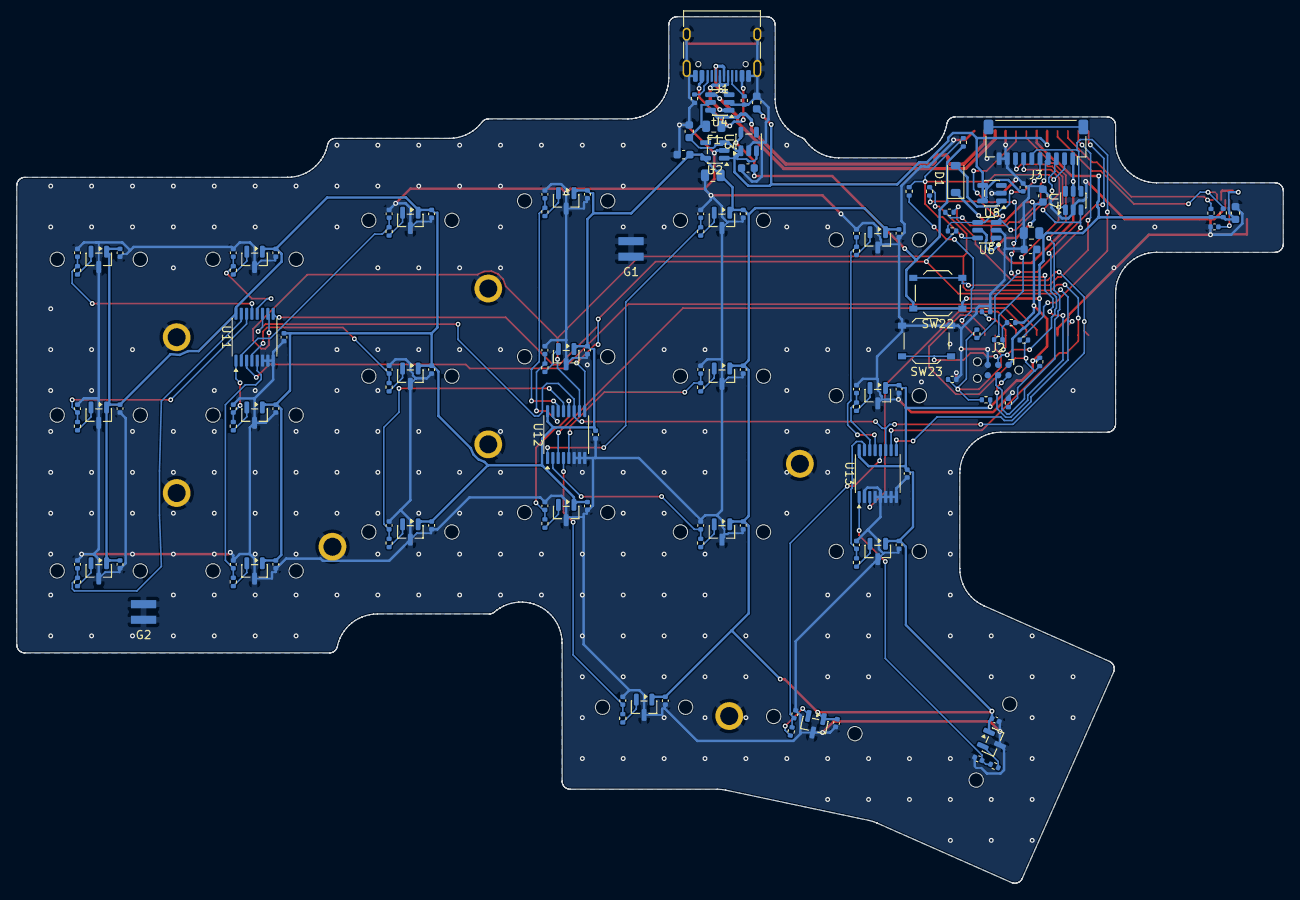
[picture p37: board vgacorne-main.kicad_pcb from below]

Board: 2 copper layers, 154.9 x 105.9 mm, 164 parts (134 on the bottom side), 79 nets.
