antwang0/VGACorne/hardware/kicad/module_f446/vgacorne-module-f446.kicad_pcb

## KiCad design hardware/kicad/module_f446/vgacorne-module-f446.kicad_pcb (2026-10-01)

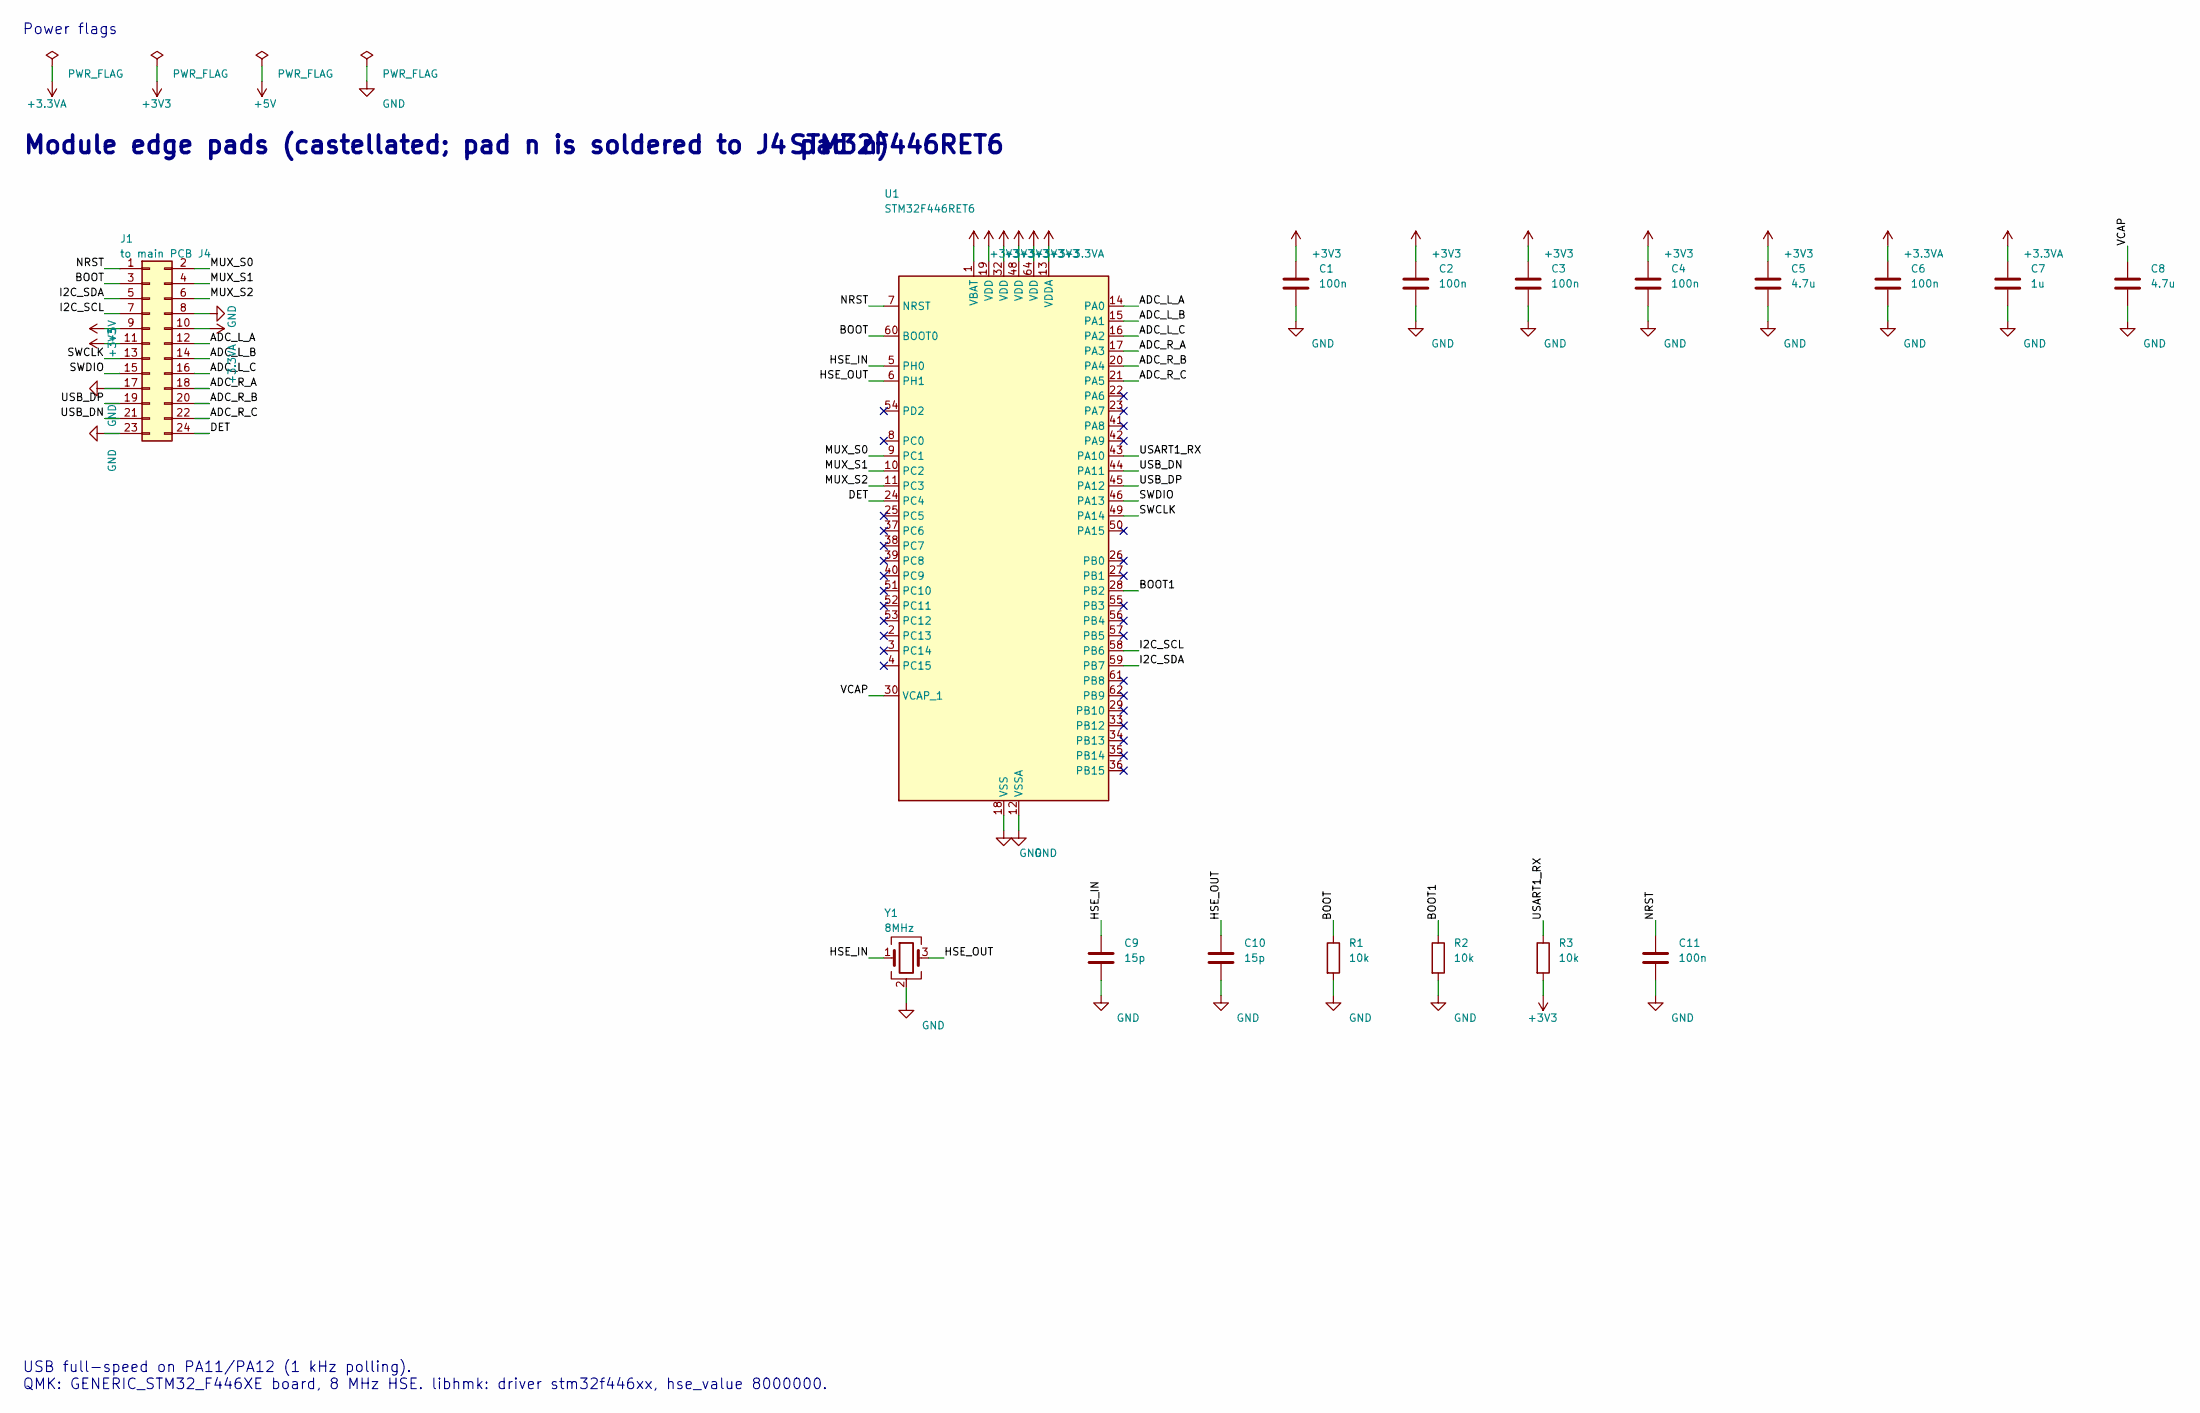
[picture p38: schematic vgacorne-module-f446.kicad_sch, VGACorne MCU module - STM32F446RET6 (QMK / libhmk, USB FS)]

Parts:
C1, C2, C3, C4, C6, C11: 100n; C_0402_1005Metric
C5, C8: 4.7u; C_0603_1608Metric
C7: 1u; C_0603_1608Metric
C9, C10: 15p; C_0402_1005Metric
J1: to main PCB J4; Module_Castellated_2x12_P1.27mm_19.4x25mm
R1, R2, R3: 10k; R_0402_1005Metric
U1: STM32F446RET6; LQFP-64_10x10mm_P0.5mm; MPN STM32F446RET6
Y1: 8MHz; Crystal_SMD_3225-4Pin_3.2x2.5mm; MPN X32258MOB4SI

Connections:
+3.3VA: C6.1, C7.1, J1.10, U1.13 (VDDA)
+3V3: C1.1, C2.1, C3.1, C4.1, C5.1, J1.11, R3.2, U1.1 (VBAT), U1.19 (VDD), U1.32 (VDD), U1.48 (VDD), U1.64 (VDD)
+5V: J1.9
/ADC_L_A: J1.12, U1.14 (PA0)
/ADC_L_B: J1.14, U1.15 (PA1)
/ADC_L_C: J1.16, U1.16 (PA2)
/ADC_R_A: J1.18, U1.17 (PA3)
/ADC_R_B: J1.20, U1.20 (PA4)
/ADC_R_C: J1.22, U1.21 (PA5)
/BOOT: J1.3, R1.1, U1.60 (BOOT0)
/BOOT1: R2.1, U1.28 (PB2)
/DET: J1.24, U1.24 (PC4)
/HSE_IN: C9.1, U1.5 (PH0), Y1.1
/HSE_OUT: C10.1, U1.6 (PH1), Y1.3
/I2C_SCL: J1.7, U1.58 (PB6)
/I2C_SDA: J1.5, U1.59 (PB7)
/MUX_S0: J1.2, U1.9 (PC1)
/MUX_S1: J1.4, U1.10 (PC2)
/MUX_S2: J1.6, U1.11 (PC3)
/NRST: C11.1, J1.1, U1.7 (NRST)
/SWCLK: J1.13, U1.49 (PA14)
/SWDIO: J1.15, U1.46 (PA13)
/USART1_RX: R3.1, U1.43 (PA10)
/USB_DN: J1.21, U1.44 (PA11)
/USB_DP: J1.19, U1.45 (PA12)
/VCAP: C8.1, U1.30 (VCAP_1)
GND: C1.2, C2.2, C3.2, C4.2, C5.2, C6.2, C7.2, C8.2, C9.2, C10.2, C11.2, J1.8, J1.17, J1.23, R1.2, R2.2, U1.12 (VSSA), U1.18 (VSS), U1.31 (VSS), U1.47 (VSS), U1.63 (VSS), Y1.2 (G), Y1.4 (G)

Notes on the sheet:
Module edge pads (castellated; pad n is soldered to J4 pad n)
STM32F446RET6
USB full-speed on PA11/PA12 (1 kHz polling). QMK: GENERIC_STM32_F446XE board, 8 MHz HSE. libhmk: driver stm32f446xx, hse_value 8000000.
Power flags

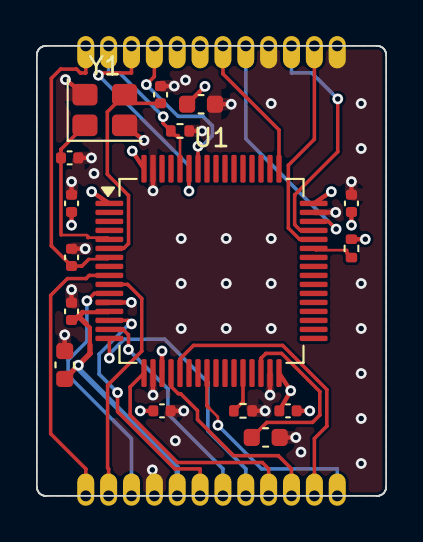
[picture p39: board vgacorne-module-f446.kicad_pcb from above]

Board: 4 copper layers, 19.4 x 25.0 mm, 17 parts (0 on the bottom side), 26 nets.
