antwang0/VGACorne/hardware/kicad/link/vgacorne-link.kicad_pcb

## KiCad design hardware/kicad/link/vgacorne-link.kicad_pcb (2026-09-30)

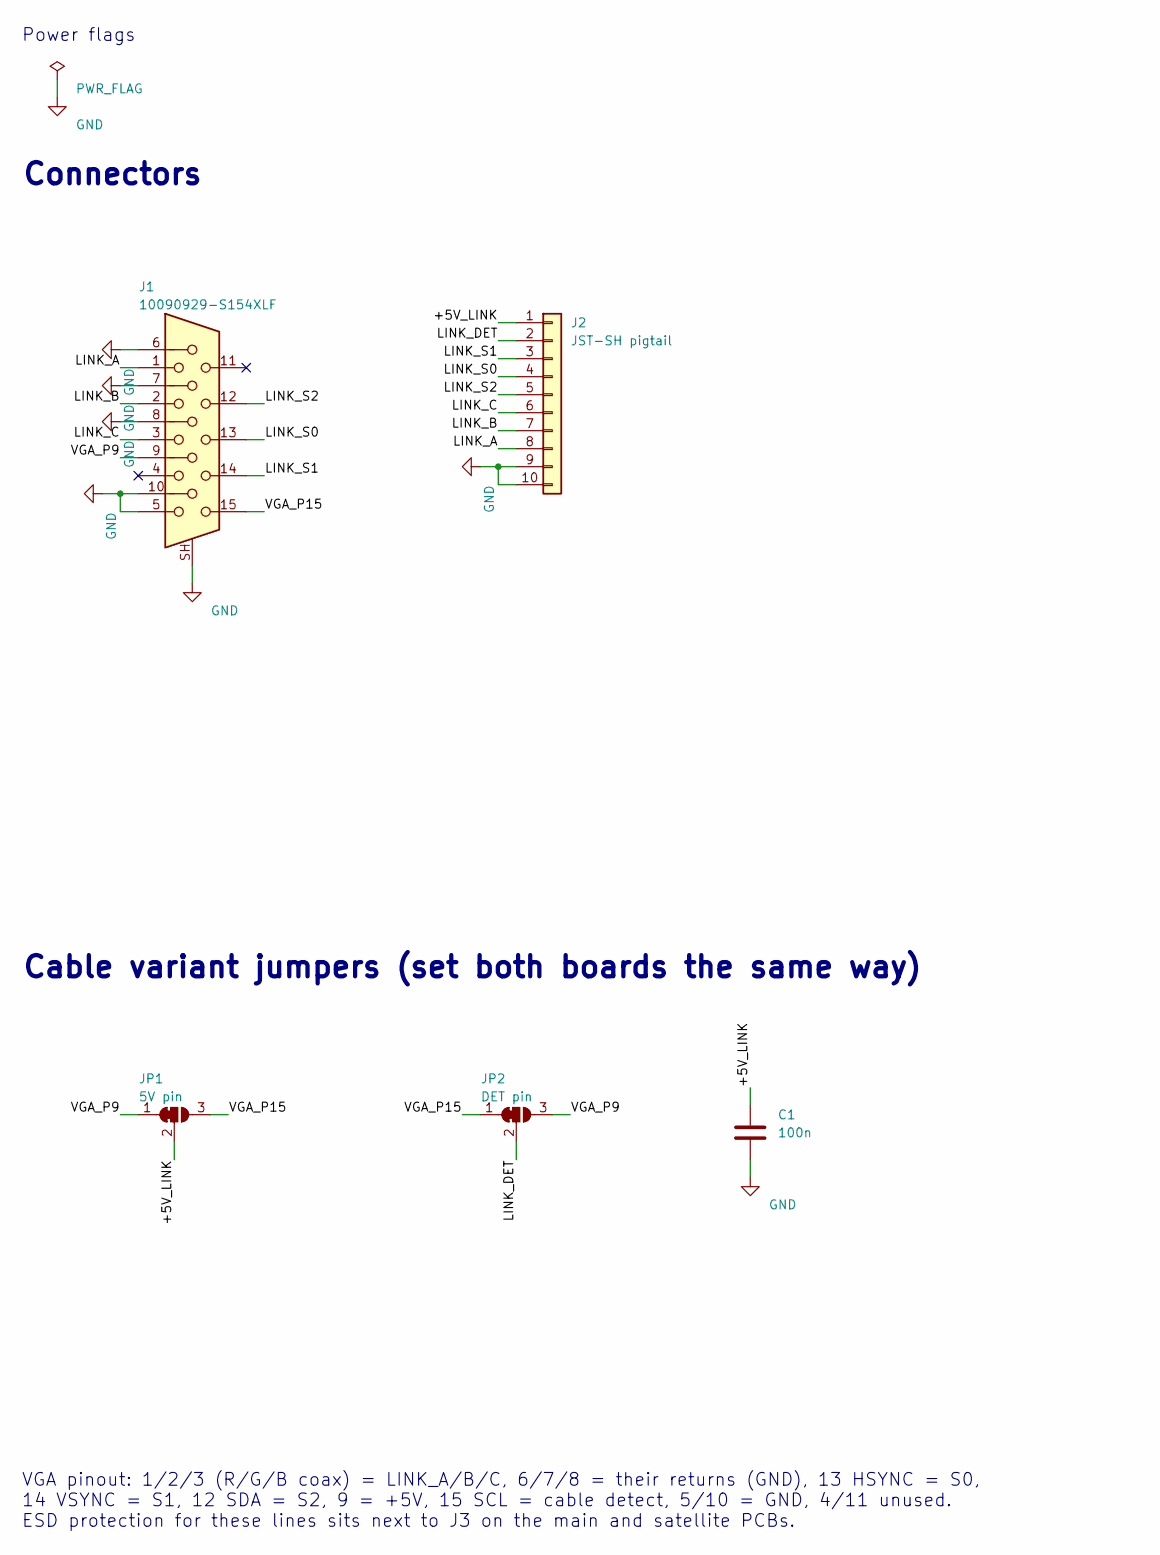
[picture p40: schematic vgacorne-link.kicad_sch, VGACorne - VGA link daughterboard]

Parts:
C1: 100n; C_0402_1005Metric
J1: 10090929-S154XLF; DSUB-15-HD_Socket_Vertical_P2.29x1.98mm_Amphenol_10090929; MPN Amphenol FCI 10090929-S154XLF
J2: JST-SH pigtail; WirePads_1x10_P1.6mm
JP1: 5V pin; SolderJumper-3_P1.3mm_Bridged12_RoundedPad1.0x1.5mm
JP2: DET pin; SolderJumper-3_P1.3mm_Bridged12_RoundedPad1.0x1.5mm

Connections:
/+5V_LINK: C1.1, J2.1, JP1.2 (C)
/LINK_A: J1.1, J2.8
/LINK_B: J1.2, J2.7
/LINK_C: J1.3, J2.6
/LINK_DET: J2.2, JP2.2 (C)
/LINK_S0: J1.13, J2.4
/LINK_S1: J1.14, J2.3
/LINK_S2: J1.12, J2.5
/VGA_P9: J1.9, JP1.1 (A), JP2.3 (B)
/VGA_P15: J1.15, JP1.3 (B), JP2.1 (A)
GND: C1.2, J1.5, J1.6, J1.7, J1.8, J1.10, J1.SH, J2.9, J2.10

Notes on the sheet:
Connectors
Cable variant jumpers (set both boards the same way)
VGA pinout: 1/2/3 (R/G/B coax) = LINK_A/B/C, 6/7/8 = their returns (GND), 13 HSYNC = S0, 14 VSYNC = S1, 12 SDA = S2, 9 = +5V, 15 SCL = cable detect, 5/10 = GND, 4/11 unused. ESD protection for these lines sits next to J3 on the main and satellite PCBs.
Power flags

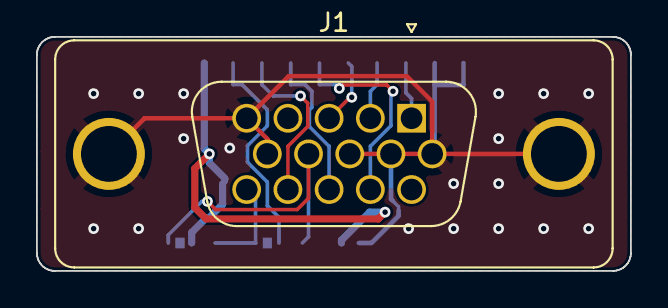
[picture p41: board vgacorne-link.kicad_pcb from above]

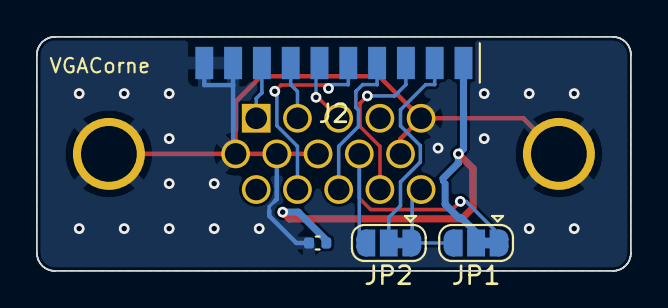
[picture p42: board vgacorne-link.kicad_pcb from below]

Board: 2 copper layers, 33.0 x 13.0 mm, 5 parts (4 on the bottom side), 11 nets.
