antwang0/VGACorne/(commit log)

2026-09-27 Add VGACorne rev 0.1 design: HE split Corne with VGA link
    Hall-effect split Corne with a single MCU. The right half is passive: its
    three analog mux outputs travel over the VGA cable's R/G/B coax pairs, and
    the select lines ride HSYNC/VSYNC/SDA. The MCU sits on a swappable module:
    AT32F405 (libhmk, USB HS) or STM32F446 (QMK or libhmk, USB FS).
    - hardware/generate.py builds the KiCad 10 projects (main, satellite, VGA
    daughterboard, two MCU modules), libhmk keyboard definitions traced from
    the schematics, plate/foam/case-plan DXFs and BOMs, and runs checks: ERC,
    DRC with schematic parity, net classes, netlist intent, module connector
    mating and firmware freshness.
    - PCBs are placed wi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
    [case-plan-left.dxf, case-plan-right.dxf, foam-case-left.dxf, foam-case-right.dxf, foam-plate-left.dxf, foam-plate-right.dxf, pcb-outline-left.dxf, pcb-outline-right.dxf]
2026-09-27 Add QMK port for the STM32F446 module
    QMK has no hall-effect support, so the keyboard carries its own analog
    matrix (custom matrix lite). Each scan steps the shared mux selects and
    converts all six ADC inputs in one sequence; keys get a filtered reading,
    start-up rest calibration, learned bottom-out, a log travel curve, and
    fixed actuation or rapid trigger. The cable-detect line holds the right
    half released while the VGA cable is out and recalibrates it on reconnect.
    - keyboard.json layout and he_wiring.h are generated from the same
    schematic trace as the libhmk configs (hardware/vgacorne/qmk.py).
    - HE_* keycodes adjust actuation and rapid trigger; settings persist via
    QMK's legacy wea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
    [checks.py, circuits.py, config.h, firmware.py, he_matrix.c, he_matrix.h]
2026-09-28 Add trackpad, mouse column and scroll wheel; move MCU and ports
    Layout
    - MCU module, USB-C and trackpad move to the right half; the left half
    is now the passive satellite.
    - VGA daughterboard bay moves to the inner-back corner so both cables
    leave from the back face. The bay sits 4.5 mm further back than the
    keys need, so both halves are 116 mm deep.
    - Azoteq TPS65 trackpad, landscape, right beside Y/H/N under a 1 mm
    overlay. The MCU module moves to a PCB ear behind it, next to the
    VGA bay. trackpad.py selects the pad (TPS65 or 40 mm Cirque); the
    case pocket, J5 connector and QMK driver follow the selection.
    - Left half: a mouse column beside T/G/B with a scroll wheel (Bourns
    P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
    [case-plan-left.dxf, case-plan-right.dxf, foam-case-left.dxf, foam-case-right.dxf, foam-plate-left.dxf, foam-plate-right.dxf, pcb-outline-left.dxf, pcb-outline-right.dxf]
2026-09-28 Document pointing-device firmware plans
    Add firmware/pointing-devices.md, covering:
    - Which firmware supports the trackpad, scroll wheel and mouse keys:
    QMK on the F446 module, libhmk on the AT32 module.
    - The cost of QMK's blocking trackpad reads: ~0.45 ms per poll, and up
    to the driver's 10 ms timeout when the pad stretches the clock.
    - A suspected tap-latch bug in QMK's Azoteq driver.
    - Plans for moving QMK's trackpad reads to a ChibiOS thread, and for
    scroll-wheel and non-blocking trackpad support in libhmk.
    Link the notes from the firmware README, the architecture doc's open
    items and the bring-up guide.
2026-09-28 Replace the scroll wheel with a rotary encoder knob
    The left half's mouse column now runs, top to bottom: right click beside
    T, left click beside G, and a rotary encoder with a knob beside B, all
    in line with column 5's rows.
    - Encoder: Bourns PEC12R-4220F-N0024 (upright, 20 mm shaft, 24
    detents, no switch). It sits in a normal 14 mm plate cutout, which
    replaces the wheel notch. The knob is 16 mm across.
    - Same readout as before: the A/B contacts are summed into four levels
    on the satellite's last spare mux channel. Nets, QMK defines and code
    are renamed from wheel to encoder (ENC, HE_ENCODER_*).
    - The link connector J3 goes back to its original spot, now that the
    encoder legs are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
    [case-plan-left.dxf, case-plan-right.dxf, foam-case-left.dxf, foam-case-right.dxf, foam-plate-left.dxf, foam-plate-right.dxf, pcb-outline-left.dxf, pcb-outline-right.dxf]
2026-09-29 Solder the MCU module flat under the trackpad
    The plug-in module stood 8 mm tall on a 2x12 socket, on a PCB ear
    behind the trackpad that reached back to the rear face. That kept the
    right half's back edge straight across most of the trackpad.
    It is now a castellated stamp module:
    - 19.4 x 25 mm, with 2x12 half-holes at 1.27 mm and every part on top.
    - Soldered onto landing pads J4 on the main PCB's tab, beside Y/H/N,
    under the trackpad.
    - About 2.7 mm tall: 1.6 mm below the TPS65's well, 2.2 mm below the
    Cirque's.
    With the ear gone, a small PCB tongue under the pad carries its FFC
    connector J5. The case back now tapers right from the keys; size and
    port positions are unchanged.
    - New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
    [case-plan-left.dxf, case-plan-right.dxf, foam-case-left.dxf, foam-case-right.dxf, foam-plate-left.dxf, foam-plate-right.dxf, pcb-outline-left.dxf, pcb-outline-right.dxf]
2026-09-29 Fix design audit findings
    Electrical:
    - Re-map the castellated module's pads so neighbours on each edge follow
    the LQFP: USB D+/D- together between grounds at the corner nearest the
    USB-C, the six ADC inputs grouped beside +3.3VA, a ground away from the
    select lines.
    - Put 1k between each DRV5055 output and its 4.7n cap (TI: no capacitor
    straight on the output).
    - STM32F446 module: pull PB2/BOOT1 down so BOOT reaches DFU; pull PA10 up.
    - Replace the XC6206 with a second TLV75733, and the link polyfuse with a
    TPS2051C switch (soft start, current limit) so hot-plugging the satellite
    can't brown out the MCU. F1 is now 750 mA.
    - USB net class 0.4/0.15 mm: ~97 ohm differential against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
    [case-plan-left.dxf, case-plan-right.dxf, foam-case-left.dxf, foam-case-right.dxf, foam-plate-left.dxf, foam-plate-right.dxf, pcb-outline-left.dxf, pcb-outline-right.dxf]
2026-09-29 Document the DRV5055's LBC8 and LBC9 current
    TI confirmed on E2E that the 2 mA / 4 mA figures belong to parts built on
    its newer LBC9 process (packaging labelled "Rev: C", "CSO: RFAB"); older
    LBC8 stock still draws 6 / 10 mA. The power budget and bring-up guide now
    say which is which, how to ask for the new parts, and how to tell what
    you got.
2026-09-29 Add a sensor comparison; start bottom-out calibration at 400
    docs/sensors.md compares the Hall and TMR sensors that could sit on the
    SOT-23 footprint (current, sensitivity and range at 3.3 V, noise, output
    load, stock) and estimates the field each common HE switch gives at our
    sensor under the 1.6 mm PCB. It records why the DRV5055A3 stays, with the
    MT9102ET as second source and the TMR2617S as the TMR part worth a bench
    test.
    The initial bottom-out threshold drops from HE60's 650 counts to 400:
    the weaker switches may swing less than 650 counts here, and both
    firmwares extend the bottom-out as keys are pressed further.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
    [circuits.py]
2026-09-30 Use the Amphenol FCI 10090929-S154XLF VGA socket
    A vertical HD-15 socket with 4-40 clinch nuts and board locks, in stock
    at Digi-Key. The board locks, soldered into the plated mounting holes,
    tie the shell (and through the jackscrews, the case) to GND. The library
    gains a copy of KiCad's vertical HD-15 footprint with the 1.2 mm pin
    holes and 3.1 mm board-lock holes Amphenol specifies.
    Keystone 7229 jackscrews (0.187" hex, 0.25" stud) fix it to the 1.6 mm
    wall; the docs cover soldering the board locks, clipping the pin tails
    and checking the board-to-flange height on the first part.
    [vgacorne-link.csv, vgacorne-link.kicad_pcb, vgacorne-link.kicad_sch]
2026-09-30 Route the VGA daughterboard with Freerouting
    hardware/route.py drives Freerouting directly (the KiCad MCP's autorouter
    trips over a pcbnew/Python 3.14 binding bug): signals first with the
    ground pours as planes, then ground as tracks round the locked signals,
    then the pours and ground stitching vias. The daughterboard routes
    completely and passes DRC.
    To make it routable:
    - the 10-pin link order now follows the DE-15 under the pigtail pads
    (J3 on both halves follows; the pigtail stays 1:1, +5 V on pin 1);
    - the pigtail pads are shorter and at the board edge, leaving a via
    channel above the connector;
    - the socket keeps KiCad's 1.6 mm pads round Amphenol's 1.2 mm holes,
    so a track fits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
    [vgacorne-link.kicad_pcb, vgacorne-link.kicad_sch, vgacorne-main.kicad_pcb, vgacorne-main.kicad_sch, vgacorne-module-at32.kicad_pcb, vgacorne-module-f446.kicad_pcb, vgacorne-satellite.kicad_pcb, vgacorne-satellite.kicad_sch]
2026-09-30 Make the MCU modules 4-layer and route them
    The modules are now 1.0 mm 4-layer boards with a solid GND plane on In1
    and +3V3 on In2, so every cap and supply pin drops a via and the signals,
    USB included, run over unbroken ground. Their support parts are placed
    beside the LQFP pins they serve (each 100 nF at its supply pin, the
    crystal at the oscillator pins). Module net classes: 0.15 mm clearance,
    USB 0.2/0.15 mm (~91 ohm over the plane on JLC's 1.0 mm stack-up).
    Castellated pads connect solidly to the planes.
    route.py learns to route to castellated edge pads (routing area grown
    past the edge, keepouts holding the copper-to-edge clearance), to fan
    plane-net pads out to their own vias before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
    [vgacorne-link.kicad_pcb, vgacorne-main.kicad_pcb, vgacorne-module-at32.kicad_pcb, vgacorne-module-f446.kicad_pcb, vgacorne-satellite.kicad_pcb]
2026-10-01 Route the satellite and most of the main board
    route.py now runs its strategies in parallel and keeps the first that
    connects everything, streams Freerouting's logs to route-logs/, drops stray
    vias, adds a finishing pass on boards left with gaps, and stitches ground
    every 5 mm on large boards (2.5 mm on small ones).
    The satellite is fully routed. On the main board the regulators moved to
    the USB-C ear and the remote ADC resistors to the module's ADC pads, which
    took the unconnected count from 9 to 3. The Power class is 0.3 mm so
    tracks can enter 0.5 mm-pitch pads.
    The main board is not finished: LINK_B (J3.7-U7.3), VBUS at USB-C A4 and
    LINK_A at R8.1 are still open, C18's ground pad has no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
    [vgacorne-main.kicad_pcb, vgacorne-satellite.kicad_pcb]
2026-10-01 Add JLC fab outputs; switch the HSE crystals to 12 pF load
    `generate.py fab` writes each board's JLCPCB files into hardware/fab/
    (git-ignored): a Gerber and drill zip with JLC's KiCad settings, and a BOM
    and placement file for the parts with an LCSC number. The numbers live in
    vgacorne/fab.py, checked against JLC's library on 2026-10-01; the step
    lists the parts without one, which are the hand-fitted ones (J4/J5, ENC1,
    the daughterboard's socket and pigtail).
    The 20 pF-load crystals with 30 pF caps came to gm_crit ~0.96 mA/V
    (AN2867), against the STM32F446's 1 mA/V limit, and the caps were outside
    the MCUs' 5-25 pF range. Both modules now use YXC's 12 pF versions
    (X32258MOB4SI, X322512MOB4S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
    [vgacorne-module-at32.csv, vgacorne-module-at32.kicad_pcb, vgacorne-module-at32.kicad_sch, vgacorne-module-f446.csv, vgacorne-module-f446.kicad_pcb, vgacorne-module-f446.kicad_sch]
2026-10-02 Add the 3D case (STEP per half) with a fit check; add TODO.md
    `generate.py case` (vgacorne/case3d.py, build123d) extrudes the 2D case
    plan into a CNC tray and frame per half, split at the plate's underside:
    floor holes and pockets, walls, gasket pockets for 25% compression, the
    1.5 mm roof, the bezel opening, the trackpad counterbore and well, the
    DE-15, USB-C and jackscrew holes, and eight M3 x 12 button-head screws
    per half in 4 mm counterbores. Outlines are rebuilt as true lines and
    arcs. STEP files are only rewritten when their geometry changes.
    The fit check builds the PCB, plate, daughterboard, MCU module,
    trackpad, encoder and USB-C as solids and fails on any overlap with the
    case; i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
    [case-left-frame.step, case-left-tray.step, case-right-frame.step, case-right-tray.step]
2026-10-02 Case: printed (heat-set inserts) and aluminium (tapped) builds; tripod mounts
    `generate.py case` now writes each half in two builds that share screw
    positions:
    - `tapped` for aluminium (CNC 6061 or SLM AlSi10Mg): M3 tapped in the
    frame, 1/4"-20 tapped in the floor, plus a DXF per part tabulating
    every hole and thread for the machine shop, since none reads threads
    from a STEP file;
    - `inserts` for FDM prints, with STL: ruthex M3 x 4 inserts in the frame,
    1/4"-20 x 6.4 inserts for the mounts, and a floor 2 mm thicker
    underneath so the insert fits (a pad would overhang the print bed).
    Each half gets two 1/4"-20 sockets, about 38 mm apart front to back near
    the centre of mass, in boss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
    [case-left-frame-inserts.step, case-left-frame-inserts.stl, case-left-frame-tapped.dxf, case-left-frame-tapped.step, case-left-tray-inserts.step, case-left-tray-inserts.stl, case-left-tray-tapped.dxf, case-left-tray-tapped.step]
2026-10-02 Add docs/mounting.md: tenting and desk-mounting comparison tables
    Two tables of what fits the case's 1/4"-20 sockets, from research on
    2026-10-01: tenting stands (tripods, ball heads, tilt heads, MagSafe
    stands, legs, adhesive feet, printable stands) and desk/chair mounts
    (clamps and arms, Arca quick releases, chair pole arms, under-desk trays
    and boards, extrusion, custom plates), each with price, load and whether
    it suits the halves, plus picks and sources. mechanical.md keeps the
    socket interface and links to it.
2026-10-02 Docs: advise against MagSafe tenting stands
    A MagSafe stand's magnet sits 7-9 mm under the Hall sensors and adds an
    estimated 10-35 mT to the keys over its ring, about a full keypress.
    Attached or removed while the board is powered, it makes those keys read
    as pressed or go dead until recalibration, and it can push strong
    switches past the DRV5055A3's range. mounting.md now marks the MagSafe
    stands as not recommended, explains why, and suggests an Arca quick
    release instead; mechanical.md's magnetics note says no magnets under
    the case.
2026-10-02 Foam and gasket plan: PORON throughout; 3.18 mm gaskets; 1 mm under the PCB
    docs/mechanical.md's "Poron or silicone" section becomes "Foam and
    gaskets": which material, grade and thickness for each soft layer, gasket
    options with clamp force and flex, where to buy small amounts, and how to
    cut them. From datasheet research:
    - PORON 4701-30 gaskets: about 13 N of case clamp per half and 0.15/0.44
    mm of flex (middle/corner key, 5 N). Solid Shore 30-40A silicone, the
    old alternative, is 10-30x stiffer: 140-370 N and almost no flex.
    - 1.5 mm case foam, not 2 mm: with thickness tolerance and adhesive, 2 mm
    left only ~0.3 mm of the 0.5 mm air gap. STACK now has 1.5 mm foam and
    1 mm of air;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
    [case-left-frame-inserts.step, case-left-frame-inserts.stl, case-left-frame-tapped.step, case-left-tray-inserts.step, case-left-tray-inserts.stl, case-left-tray-tapped.dxf, case-left-tray-tapped.step, case-right-frame-inserts.step]
2026-10-20 libhmk: hot-plug the VGA cable (detachable.patch); note Freerouting 2.5.0 trial
    - firmware/libhmk/detachable.patch: optional `detachable` block in libhmk's
    keyboard.json (detect pin + keys). While detached the keys are held
    released and their floating inputs ignored; on attach their rest values are
    relearned over 500 ms without blocking the rest of the keyboard.
    - firmware.py generates the block from the schematics: DET (PC4, active low)
    and the left half's 23 keys.
    - Host test of the patched matrix.c against a simulated cable
    (firmware/libhmk/tests); generate.py check runs it with LIBHMK set and flags
    a libhmk checkout without the patch.
    - Docs: build steps apply the patch, brin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
2026-10-22 Main board fully routed: spread out the link cluster; fix starved pads
    - pcb.py: autoplace takes a courtyard gap; LINK_GAP = 1.0 mm (was 0.15) for
    the link and ADC-resistor groups beside the module. 20 small bottom-side
    parts move 1-10 mm; connectors, module, switches and bosses stay put.
    - Re-routed with route.py (Freerouting 2.4.1): 0 unconnected, against 3
    before. Of 0.5/0.8/1.0/1.2/1.5 mm gaps, 1.0 mm routed cleanest.
    - route.py: fix_starved() gives any ground pad DRC finds short of thermal
    spokes a solid connection and a via of its own (R15 here; C18 before).
    fanout() can now place vias around existing tracks.
    - generate.py check passes on every board for the first time; the 3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
2026-11-02 Main board: route the USB pair as a differential pair
    - The F.Cu tracks of USB_DP/USB_DN are relaid by hand (pcbnew script) as a
    0.4 mm / 0.15 mm pair: J4 breakout, the run along the notch and the NE
    diagonal to the vias by U4 all at 0.55 mm pitch. Freerouting had left the
    diagonal at 1.04 mm to clear the VBUS via, and the ends apart.
    - Both vias and the B.Cu stubs into U4 stay: the connector cluster leaves no
    room to move them, so the last 1-6 mm into U4 remain single-ended.
    - A trombone on USB_DN after the breakout matches the lengths to 0.01 mm
    (41.46 vs 41.45 mm; 2.3 mm apart before). 76 % of DP's F.Cu runs coupled,
    against 51 %.
    - Zones refilled through kicad-cli (in-process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
2026-11-02 Ground the plate, the encoder and an aluminium case
    docs/grounding.md is the plan: every conductor a hand can reach gets a short
    path to the USB ground, so an aluminium case can't float and charge up, and
    the discharge never has to cross a signal net (the Unicorne's dead rows and
    columns). The PCB side is done here; the case's bare-spot layer is next.
    - Standoff_M2: 2.2 mm PTH with a 3.4 mm GND pad on both sides, and the
    standoffs are MountingHole_Pad on GND, so the brass standoffs tie an
    aluminium plate to ground at 7-8 points.
    - G1/G2 on each half: Wurth WE-SECF 331236362553 SMT spring fingers on the
    underside, pressing on the case floor 4.0 mm below (3.4-5.0 mm working
    height). P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
2026-11-02 Case: BARE layer for the anodiser (seam face, DE-15 flange seat, finger pads)
    The last piece of docs/grounding.md. Anodising insulates, so the case plan
    and the tapped builds' hole drawings now show what stays bare:
    - BARE: the seam face (the wall ring: tray top and frame underside) and the
    DE-15 flange seat inside the back wall, drawn as the wall behind it;
    - BARE_FLOOR: a dia 8 pad on the floor top under each spring finger G1/G2,
    read from the board like the floor pockets, listed as D1/D2 on the tray
    drawing.
    Drawing notes ask for masking (or a 0.05 skim after), chem film per
    MIL-DTL-5541 Type II Class 3, and under 0.1 ohm between bare areas. The
    STEP files don't change: finish isn't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
2026-11-02 Fab: have JLC place J5 and ENC1
    LCSC numbers for the trackpad FFC connector (AFC07-S06FCA-00, C262553) and
    the encoder (PEC12R-4220F-N0024, C143785), so the main and satellite boards
    go out as two-sided assembly and the hand work is the MCU module, the spring
    fingers and the daughterboards. J5's MPN field loses the LCSC note it
    carried, since fab.py's table has it now; the board's field follows.
2026-11-03 Case files: one folder per build
    mechanical/case-machined/ holds the aluminium build (STEP + .dxf hole and
    BARE drawing per part), mechanical/case-printed/ the FDM build (STEP + STL
    per part), each as case-<side>-<tray|frame>; the -tapped/-inserts suffixes go.
    Build gets a `folder`; write() and check() use it. The STEPs change only in
    their product name. Docs follow.
2026-11-03 Add docs/cost.md: JLC quotes and build cost estimates
    The 2026-11-03 quotes (main board: 5 assembled for 175.22; case-left-tray:
    61.39 anodised and threaded) and what they imply: about 860-1,030 for one
    aluminium unit with four spare board sets, about 430-590 each for five.
    Linked from the README, TODO and the order list.
2026-11-03 mounting.md: a plan for tenting under the desk
    One concrete setup on top of the comparison tables: each half on its own
    desk-edge clamp and friction arm, hanging below the front edge, tented
    20-30 deg at lap height, with an Arca plate on both sockets and a quick
    release. Geometry to set first, the 3 kg load rule, parts per half in a
    premium and a budget pair, assembly steps, first-week checks, and when to
    move to an extrusion rail, the Humanscale track or the chair instead.
